HexFud/OptiLogic-16-Pro/bom.csv

Index | LCSC# | MPN | Manufacturer | Package | Customer # | Description | RoHS | Quantity | MOQ | Multiple | Unit Price ($) | Extended Price ($) | Product Link
1 | C17615 | 0805W8F390KT5E | UNI-ROYAL | 0805 |  | 3.9Ω ±1% 125mW 0805 Thick Film Resistor | yes | 100 | 100 | 100 | 0.0056 | 0.56 | https://www.lcsc.com/product-detail/C17615.html
2 | C58758 | KSZ9031RNXCA | MICROCHIP | QFN-48-EP(7x7) |  | PHY Transceiver RGMII QFN-48-EP(7x7) Drivers, Receivers, Transceivers RoHS | yes | 1 | 1 | 1 | 5.8153 | 5.82 | https://www.lcsc.com/product-detail/C58758.html
3 | C22018717 | Y97KT23B0NAFP | C&K | - |  | Tactile Switches RoHS | yes | 1 | 1 | 1 | 0.2131 | 0.21 | https://www.lcsc.com/product-detail/C22018717.html
4 | C3180007 | 0826-1X1T-GH-F | Bel Fuse | Through Hole |  | Jack Modular Connector Through Hole Shielded | yes | 1 | 1 | 1 | 13.8559 | 13.86 | https://www.lcsc.com/product-detail/C3180007.html
5 | C17607 | 0805W8F3091T5E | UNI-ROYAL | 0805 |  | 3.09kΩ ±1% 125mW 0805 Thick Film Resistor | yes | 100 | 100 | 100 | 0.0047 | 0.47 | https://www.lcsc.com/product-detail/C17607.html
6 | C17593 | 0805W8F2702T5E | UNI-ROYAL | 0805 |  | 27kΩ ±1% 125mW 0805 Thick Film Resistor | yes | 100 | 100 | 100 | 0.0029 | 0.29 | https://www.lcsc.com/product-detail/C17593.html
7 | C17448 | 0805W8F1372T5E | UNI-ROYAL | 0805 |  | 13.7kΩ ±1% 125mW 0805 Thick Film Resistor | yes | 100 | 100 | 100 | 0.0022 | 0.22 | https://www.lcsc.com/product-detail/C17448.html
8 | C17408 | 0805W8F1000T5E | UNI-ROYAL | 0805 |  | 100Ω ±1% 125mW 0805 Thick Film Resistor | yes | 100 | 100 | 100 | 0.0043 | 0.43 | https://www.lcsc.com/product-detail/C17408.html
9 | C17841 | 0805W8F820JT5E | UNI-ROYAL | 0805 |  | 82Ω ±1% 125mW 0805 Thick Film Resistor | yes | 100 | 100 | 100 | 0.0032 | 0.32 | https://www.lcsc.com/product-detail/C17841.html
10 | C113767 | W25Q128JVSIQ | Winbond | SOIC-8-208mil |  | 128Mbit 2.7V~3.6V 133MHz SPI SOIC-8-208mil Memory RoHS | yes | 1 | 1 | 1 | 2.7906 | 2.79 | https://www.lcsc.com/product-detail/C113767.html
11 | C17412 | 0805W8F1073T5E | UNI-ROYAL | 0805 |  | 107kΩ ±1% 125mW 0805 Thick Film Resistor | yes | 100 | 100 | 100 | 0.0021 | 0.21 | https://www.lcsc.com/product-detail/C17412.html
12 | C17638 | 0805W8F3483T5E | UNI-ROYAL | 0805 |  | 348kΩ ±1% 125mW 0805 Thick Film Resistor | yes | 100 | 100 | 100 | 0.0022 | 0.22 | https://www.lcsc.com/product-detail/C17638.html
13 | C25946 | 0402WGJ0822TCE | UNI-ROYAL | 0402 |  | 8.2kΩ ±5% 62.5mW 0402 Thick Film Resistor | yes | 100 | 100 | 100 | 0.0009 | 0.09 | https://www.lcsc.com/product-detail/C25946.html
14 | C17530 | 0805W8F2701T5E | UNI-ROYAL | 0805 |  | 2.7kΩ ±1% 125mW 0805 Thick Film Resistor | yes | 100 | 100 | 100 | 0.0055 | 0.55 | https://www.lcsc.com/product-detail/C17530.html
15 | C25993 | 0603WAJ0242T5E | UNI-ROYAL | 0603 |  | 2.4kΩ ±5% 100mW 0603 Thick Film Resistor | yes | 100 | 100 | 100 | 0.0020 | 0.20 | https://www.lcsc.com/product-detail/C25993.html
16 | C17414 | 0805W8F1002T5E | UNI-ROYAL | 0805 |  | 10kΩ ±1% 125mW 0805 Thick Film Resistor | yes | 200 | 100 | 100 | 0.0034 | 0.68 | https://www.lcsc.com/product-detail/C17414.html
17 | C17516 | 0805W8F2151T5E | UNI-ROYAL | 0805 |  | 2.15kΩ ±1% 125mW 0805 Thick Film Resistor | yes | 100 | 100 | 100 | 0.0047 | 0.47 | https://www.lcsc.com/product-detail/C17516.html
18 | C17713 | 0805W8F4702T5E | UNI-ROYAL | 0805 |  | 47kΩ ±1% 125mW 0805 Thick Film Resistor | yes | 100 | 100 | 100 | 0.0068 | 0.68 | https://www.lcsc.com/product-detail/C17713.html
19 | C34771 | TPS51200DRCR | TI | VSON-10-EP(3x3) |  | VSON-10-EP(3x3) Special Purpose Regulators RoHS | yes | 1 | 1 | 1 | 0.4807 | 0.48 | https://www.lcsc.com/product-detail/C34771.html
20 | C305914 | 1888247-1 | TE Connectivity | SMD,P=0.8mm,Surface Mount,Right Angle |  | 1 20P -55℃~+105℃ SMD,P=0.8mm,Surface Mount,Right Angle Pluggable Connector Assemblies RoHS | yes | 3 | 1 | 1 | 0.9163 | 2.75 | https://www.lcsc.com/product-detail/C305914.html
21 | C5137262 | SX3M25.000E20F30THN | SCTF | SMD3225-4P |  | Oscillator 25MHz ±20ppm CMOS 1.2V SMD3225-4P | yes | 5 | 1 | 1 | 0.5914 | 2.96 | https://www.lcsc.com/product-detail/C5137262.html
22 | C9006 | X322525MOB4SI | YXC Crystal Oscillators | SMD3225-4P |  | Crystal 25MHz ±10ppm 12pF SMD3225-4P | yes | 15 | 5 | 5 | 0.0959 | 1.44 | https://www.lcsc.com/product-detail/C9006.html
23 | C17226355 | SIT9365AI-4E1-25N160.000000 | SiTime | SMD7050-6P |  | SMD7050-6P Oscillators RoHS | yes | 1 | 1 | 1 | 15.2097 | 15.21 | https://www.lcsc.com/product-detail/C17226355.html
24 | C5265887 | HY50MSMD3225OB1R30 | Huiyuan crystal | SMD3225-4P |  | Crystal 50MHz ±10ppm 20pF 40Ω SMD3225-4P | yes | 5 | 5 | 5 | 0.0954 | 0.48 | https://www.lcsc.com/product-detail/C5265887.html
25 | C1550513 | FT601Q-B-T | FTDI | QFN-76-EP(9x9) |  | USB to FIFO 8 5Gbps QFN-76-EP(9x9) Controllers RoHS | yes | 1 | 1 | 1 | 13.3480 | 13.35 | https://www.lcsc.com/product-detail/C1550513.html
26 | C2984150 | XC7K70T-2FBG676C | AMD/XILINX | FBG-676 |  | 65600 FBG-676 FPGAs (Field Programmable Gate Array) RoHS | yes | 1 | 1 | 1 | 34.7593 | 34.76 | https://www.lcsc.com/product-detail/C2984150.html
27 | C54792 | TPS63700DRCR | TI | VSON-10-EP(3x3) |  | 1.38MHz Buck-Boost Adjustable -15V~-2V 360mA VSON-10-EP(3x3) Voltage Regulators - DC DC Switching Regulators RoHS | yes | 1 | 1 | 1 | 1.7582 | 1.76 | https://www.lcsc.com/product-detail/C54792.html
28 | C134558 | RGA102M1VBK-1320 | Lelon | Through Hole,D12.5xL20mm |  | 1000uF 35V Aluminum Electrolytic Capacitors Through Hole,D12.5xL20mm 2000hrs@105℃ | yes | 100 | 5 | 5 | 0.2003 | 20.03 | https://www.lcsc.com/product-detail/C134558.html
29 | C2871819 | TPS75115QPWPR | TI | HTSSOP-20-EP |  | 1.5V Positive Fixed HTSSOP-20-EP Voltage Regulators - Linear, Low Drop Out (LDO) Regulators RoHS | yes | 1 | 1 | 1 | 4.0493 | 4.05 | https://www.lcsc.com/product-detail/C2871819.html
30 | C131963 | LP5951MF-2.5/NOPB | TI | SOT-23-5 |  | 2.5V Positive Fixed SOT-23-5 Voltage Regulators - Linear, Low Drop Out (LDO) Regulators RoHS | yes | 1 | 1 | 1 | 0.4039 | 0.40 | https://www.lcsc.com/product-detail/C131963.html
31 | C91314 | MR854RLG | onsemi | DO-201AD |  | 150ns 400V 1.04V@3A 3A DO-201AD Single Diodes | yes | 10 | 10 | 10 | 0.0674 | 0.67 | https://www.lcsc.com/product-detail/C91314.html
32 | C2868758 | DAC8568ICPW | TI | TSSOP-16 |  | 5us 2.7V~5.5V 12LSB TSSOP-16 Digital to Analog Converters (DAC) RoHS | yes | 2 | 1 | 1 | 32.1387 | 64.28 | https://www.lcsc.com/product-detail/C2868758.html
33 | C29438 | TPS54620RGYR | TI | VQFN-14-EP(3.5x3.5) |  | Buck Switching Regulator IC Adjustable 0.8V~15V 1 Output 6A VQFN-14-EP(3.5x3.5) | yes | 1 | 1 | 1 | 1.3612 | 1.36 | https://www.lcsc.com/product-detail/C29438.html
34 | C46274 | REF5040AIDR | TI | SOIC-8 |  | 4.096V ±0.1% 4.296V~18V 10mA Fixed SOIC-8 Voltage Reference RoHS | yes | 1 | 1 | 1 | 1.6610 | 1.66 | https://www.lcsc.com/product-detail/C46274.html
35 | C1858145 | LQG15WZ1N4S02D | muRata | 0402 |  | 1.4nH 1A 40mΩ Standard AEC-Q200 | yes | 4 | 1 | 1 | 0.0481 | 0.19 | https://www.lcsc.com/product-detail/C1858145.html
36 | C97253 | TPS563200DDCR | TI | TSOT-23-6 |  | Buck Switching Regulator IC Adjustable 0.76V~7V 1 Output 3A TSOT-23-6 | yes | 4 | 1 | 1 | 1.0779 | 4.31 | https://www.lcsc.com/product-detail/C97253.html
37 | C49215609 | TCC0805X5R107M6R3FT | CCTC | 0805 |  | 100uF X5R ±20% 6.3V 0805 Ceramic Capacitors RoHS | yes | 10 | 1 | 1 | 0.3170 | 3.17 | https://www.lcsc.com/product-detail/C49215609.html
38 | C85840 | BLM21PG221SN1D | muRata | 0805 |  | 220Ω@100MHz 1 Line Ferrite Bead 0805 2A 45mΩ | yes | 20 | 20 | 20 | 0.0349 | 0.70 | https://www.lcsc.com/product-detail/C85840.html
39 | C18198349 | 1812L300/16GR | LUTE | 1812 |  | Polymeric PTC Resettable Fuse 16V 3A Surface Mount 1812 | yes | 10 | 10 | 10 | 0.0603 | 0.60 | https://www.lcsc.com/product-detail/C18198349.html
40 | C916421 | BAV99 | JSMSEMI | SOT-23 |  | Diode Array 1 Pair Series Connection 75V 215mA Surface Mount SOT-23 | yes | 50 | 50 | 50 | 0.0090 | 0.45 | https://www.lcsc.com/product-detail/C916421.html
41 | C2297 | KT-0805G | Hubei KENTO Elec | 0805 |  | Emerald Green 525nm LED Indication - Discrete 2.6V~3.1V 0805 | yes | 100 | 50 | 50 | 0.0166 | 1.66 | https://www.lcsc.com/product-detail/C2297.html
42 | C94121 | CC0805KRX7R9BB102 | YAGEO | 0805 |  | 1nF ±10% 50V Ceramic Capacitor X7R 0805 | yes | 100 | 100 | 100 | 0.0069 | 0.69 | https://www.lcsc.com/product-detail/C94121.html
43 | C19110 | CL21B225KAFNNNE | Samsung Electro-Mechanics | 0805 |  | 2.2uF ±10% 25V Ceramic Capacitor X7R 0805 | yes | 20 | 10 | 10 | 0.0246 | 0.49 | https://www.lcsc.com/product-detail/C19110.html
44 | C45783 | CL21A226MAQNNNE | Samsung Electro-Mechanics | 0805 |  | 22uF ±20% 25V Ceramic Capacitor X5R 0805 | yes | 100 | 20 | 20 | 0.1934 | 19.34 | https://www.lcsc.com/product-detail/C45783.html
45 | C107146 | CC0805KRX7R9BB222 | YAGEO | 0805 |  | 2.2nF ±10% 50V Ceramic Capacitor X7R 0805 | yes | 100 | 100 | 100 | 0.0075 | 0.75 | https://www.lcsc.com/product-detail/C107146.html
46 | C5441174 | 201N1Y02001 | CND-tek | Through Hole |  | Through Hole Pluggable Connector Accessories | yes | 3 | 1 | 1 | 0.6346 | 1.90 | https://www.lcsc.com/product-detail/C5441174.html
47 | C7496652 | FCC0805N430J500BT | FOJAN | 0805 |  | 43pF ±5% 50V Ceramic Capacitor COG 0805 | yes | 100 | 100 | 100 | 0.0073 | 0.73 | https://www.lcsc.com/product-detail/C7496652.html
48 | C376967 | TCC0805X7R273K500DT | CCTC | 0805 |  | 27nF ±10% 50V Ceramic Capacitor X7R 0805 | yes | 100 | 100 | 100 | 0.0085 | 0.85 | https://www.lcsc.com/product-detail/C376967.html
49 | C1804 | CL21C220JBANNNC | Samsung Electro-Mechanics | 0805 |  | 22pF ±5% 50V Ceramic Capacitor C0G 0805 | yes | 150 | 50 | 50 | 0.0123 | 1.85 | https://www.lcsc.com/product-detail/C1804.html
50 | C1779 | CL21A475KAQNNNE | Samsung Electro-Mechanics | 0805 |  | 4.7uF ±10% 25V Ceramic Capacitor X5R 0805 | yes | 120 | 20 | 20 | 0.0346 | 4.15 | https://www.lcsc.com/product-detail/C1779.html
51 | C1792 | 0805CG120J500NT | FH | 0805 |  | 12pF ±5% 50V Ceramic Capacitor C0G 0805 | yes | 100 | 100 | 100 | 0.0084 | 0.84 | https://www.lcsc.com/product-detail/C1792.html
52 | C28323 | CL21B105KBFNNNE | Samsung Electro-Mechanics | 0805 |  | 1uF ±10% 50V Ceramic Capacitor X7R 0805 | yes | 10 | 10 | 10 | 0.0330 | 0.33 | https://www.lcsc.com/product-detail/C28323.html
53 | C440199 | GRM3195C1H153JA01D | muRata | 1206 |  | 15nF ±5% 50V Ceramic Capacitor C0G 1206 | yes | 5 | 5 | 5 | 0.1554 | 0.78 | https://www.lcsc.com/product-detail/C440199.html
54 | C15850 | CL21A106KAYNNNE | Samsung Electro-Mechanics | 0805 |  | 10uF ±10% 25V Ceramic Capacitor X5R 0805 | yes | 20 | 20 | 20 | 0.0441 | 0.88 | https://www.lcsc.com/product-detail/C15850.html
55 | C167225 | FXL1040-R80-M | cjiang | SMD,11.5x10mm |  | 23A 800nH ±20% 29A 2.7mΩ Molded inductor SMD,11.5x10mm Fixed Inductors RoHS | yes | 100 | 5 | 5 | 0.3205 | 32.05 | https://www.lcsc.com/product-detail/C167225.html
56 | C134565 | RGA221M1CBK-0611 | Lelon | Through Hole,D6.3xL11mm |  | 220uF 16V Aluminum Electrolytic Capacitors Through Hole,D6.3xL11mm 2000hrs@105℃ | yes | 100 | 10 | 10 | 0.0438 | 4.38 | https://www.lcsc.com/product-detail/C134565.html
57 | C17444 | 0805W8F1202T5E | UNI-ROYAL | 0805 |  | 12kΩ ±1% 125mW 0805 Thick Film Resistor | yes | 100 | 100 | 100 | 0.0028 | 0.28 | https://www.lcsc.com/product-detail/C17444.html
58 | C17471 | 0805W8F1500T5E | UNI-ROYAL | 0805 |  | 150Ω ±1% 125mW 0805 Thick Film Resistor | yes | 100 | 100 | 100 | 0.0029 | 0.29 | https://www.lcsc.com/product-detail/C17471.html
59 | C17407 | 0805W8F1003T5E (SMT) | UNI-ROYAL | 0805 |  | 100kΩ ±1% 0805 Chip Resistor - Surface Mount | yes | 100 | 100 | 100 | 0.0028 | 0.28 | https://www.lcsc.com/product-detail/C17407.html
60 | C17526 | 0805W8F2401T5E | UNI-ROYAL | 0805 |  | 2.4kΩ ±1% 125mW 0805 Thick Film Resistor | yes | 100 | 100 | 100 | 0.0028 | 0.28 | https://www.lcsc.com/product-detail/C17526.html
61 | C17673 | 0805W8F4701T5E | UNI-ROYAL | 0805 |  | 4.7kΩ ±1% 125mW 0805 Thick Film Resistor | yes | 200 | 100 | 100 | 0.0051 | 1.02 | https://www.lcsc.com/product-detail/C17673.html
62 | C17393 | 0805W8F1651T5E | UNI-ROYAL | 0805 |  | 1.65kΩ ±1% 125mW 0805 Thick Film Resistor | yes | 200 | 100 | 100 | 0.0029 | 0.58 | https://www.lcsc.com/product-detail/C17393.html
63 | C15127 | AO3401A | AOS | SOT-23 |  | 30V 4A Surface Mount SOT-23 | yes | 100 | 5 | 5 | 0.0789 | 7.89 | https://www.lcsc.com/product-detail/C15127.html
64 | C49678 | CC0805KRX7R9BB104 | YAGEO | 0805 |  | 100nF ±10% 50V Ceramic Capacitor X7R 0805 | yes | 100 | 20 | 20 | 0.0206 | 2.06 | https://www.lcsc.com/product-detail/C49678.html
65 | C167220 | FXL0630-4R7-M | cjiang | SMD,7x6.6mm |  | 6A 4.7uH ±20% 9A 33mΩ Molded inductor SMD,7x6.6mm Fixed Inductors RoHS | yes | 15 | 5 | 5 | 0.1695 | 2.54 | https://www.lcsc.com/product-detail/C167220.html
66 | C167222 | FXL0630-8R2-M | cjiang | SMD,7x6.6mm |  | 5A 8.2uH ±20% 60mΩ 6A Molded inductor SMD,7x6.6mm Fixed Inductors RoHS | yes | 5 | 5 | 5 | 0.1695 | 0.85 | https://www.lcsc.com/product-detail/C167222.html
67 | C3095430 | JACK-L-PC-10A-RA(R) | GlobTek, Inc. | - |  | Right Angle DC Power Jack -25℃~+85℃ 2.5mm 6.5mm 10A 50V Power Connectors RoHS | yes | 1 | 1 | 1 | 4.9813 | 4.98 | https://www.lcsc.com/product-detail/C3095430.html
68 | C493445 | 733910083 | MOLEX | Through Hole |  | Connector Receptacle SMA Female Pin 50Ω Through Hole Right Angle | yes | 1 | 1 | 1 | 6.6127 | 6.61 | https://www.lcsc.com/product-detail/C493445.html
69 | C2337 | 2.54-1*40P | BOOMELE(Boom Precision Elec) | Through Hole,P=2.54mm |  | Pin Header 40 Position 2.54mm Pitch Single Row Through Hole -25℃~+85℃ | yes | 5 | 5 | 5 | 0.1607 | 0.80 | https://www.lcsc.com/product-detail/C2337.html
70 | C124380 | B-2100S06P-A110 | Ckmtw | Through Hole,P=2.54mm |  | Pin Header 6 Position 2.54mm Pitch Single Row Through Hole -40℃~+105℃ | yes | 10 | 10 | 10 | 0.0569 | 0.57 | https://www.lcsc.com/product-detail/C124380.html
71 | C2765186 | TYPE-C 16PIN 2MD(073) | SHOU HAN | SMD |  | USB-C (USB TYPE-C) Receptacle Connector 16 Position Surface Mount, Right Angle | yes | 20 | 20 | 20 | 0.0719 | 1.44 | https://www.lcsc.com/product-detail/C2765186.html
 |  |  |  |  |  | 1GBit SFP LC/LC Transciever |  | 3 |  |  |  | 47.99 | https://www.amazon.it/gp/product/B01DD0ZI7I/
 |  |  |  |  |  | LC/LC Fiber cable |  | 3 |  |  |  | 30 | https://www.amazon.it/gp/product/B0HL28KK1X/ref=ox_sc_act_title_12?smid=A3I27YI4UGWCDD&psc=1
 |  |  |  |  |  | 8 Layer PCB + stencil |  | 1 |  |  |  | 180
 |  |  |  |  |  | Laser warning sticker |  | 1 |  |  |  | 6 | https://www.amazon.it/gp/product/B09NP5HWWF/ref=ox_sc_act_title_3?smid=AZV51B80MC0DX&psc=1
 |  |  |  |  |  | Shipping + Tax |  | 1 |  |  |  | 80
 |  |  |  |  |  | TOTAL |  |  |  |  |  | 649.26
