HexFud/OptiLogic-16-Pro/Production/Case_Top.step

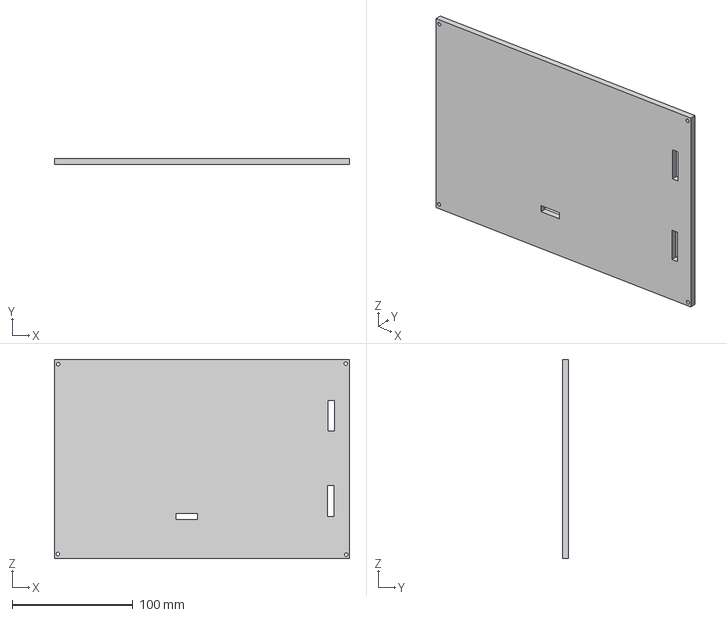
[picture p15: CAD file, 2026-10-24]
Production/Case_Top.step
244.2 x 5.00 x 164.8 mm
