HexFud/OptiLogic-16-Pro/Production/Case_Bottom.step

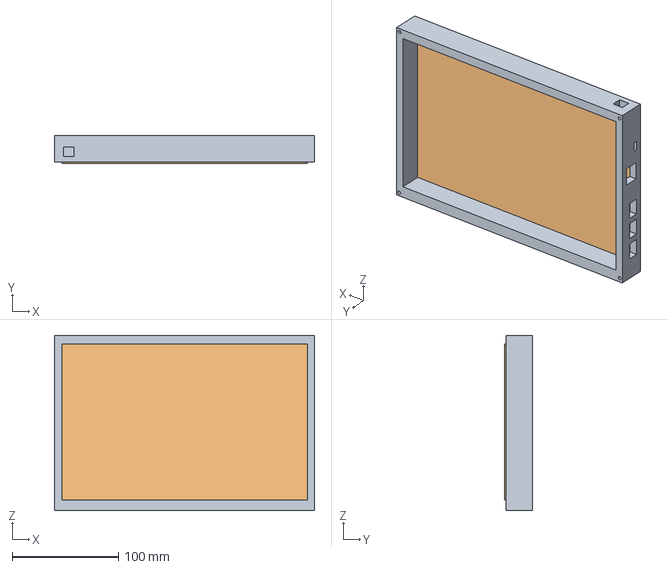
[picture p16: CAD file, 2026-10-24]
Production/Case_Bottom.step
244.2 x 26.5 x 164.8 mm
