HexFud/OptiLogic-16-Pro/(list of files, cad)

Other CAD files:
CAD/OptiLogic_Complete_model.f3z
