HexFud/OptiLogic-16-Pro/PCB/OptiLogic-16-Pro.pdf

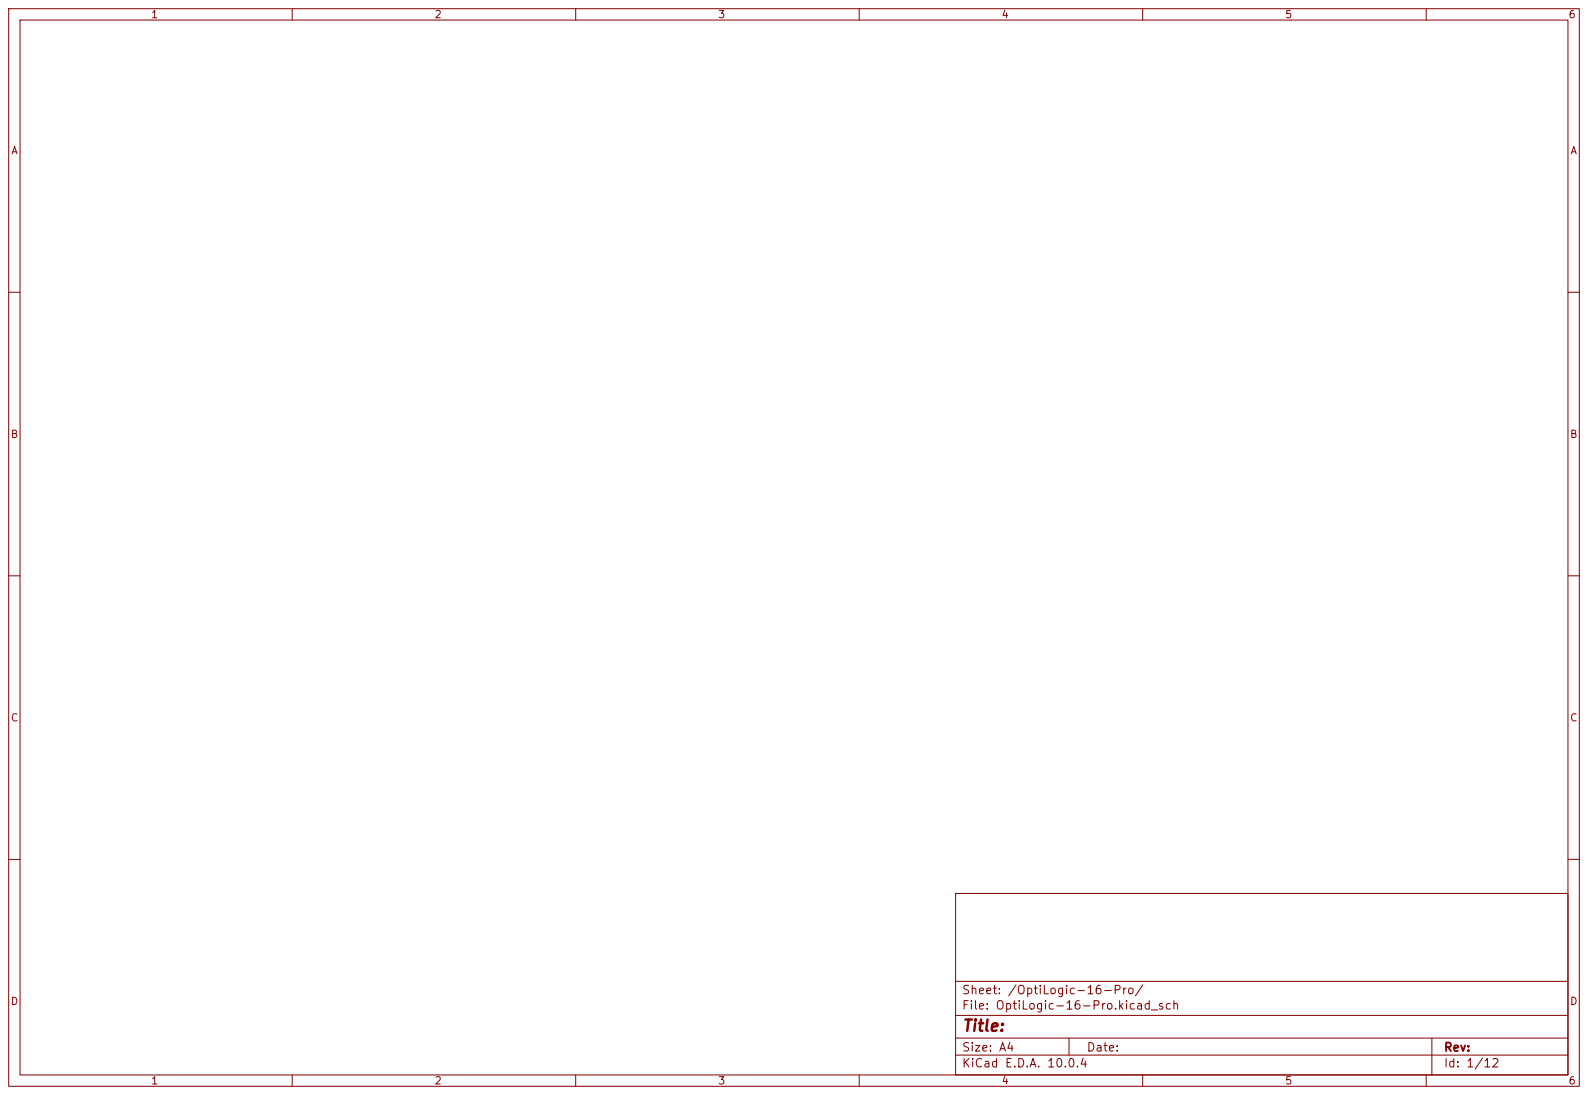
[picture p17: page 1]

Size: A4 | Rev:
KiCad E.D.A. 10.0.4 | Id: 1/12

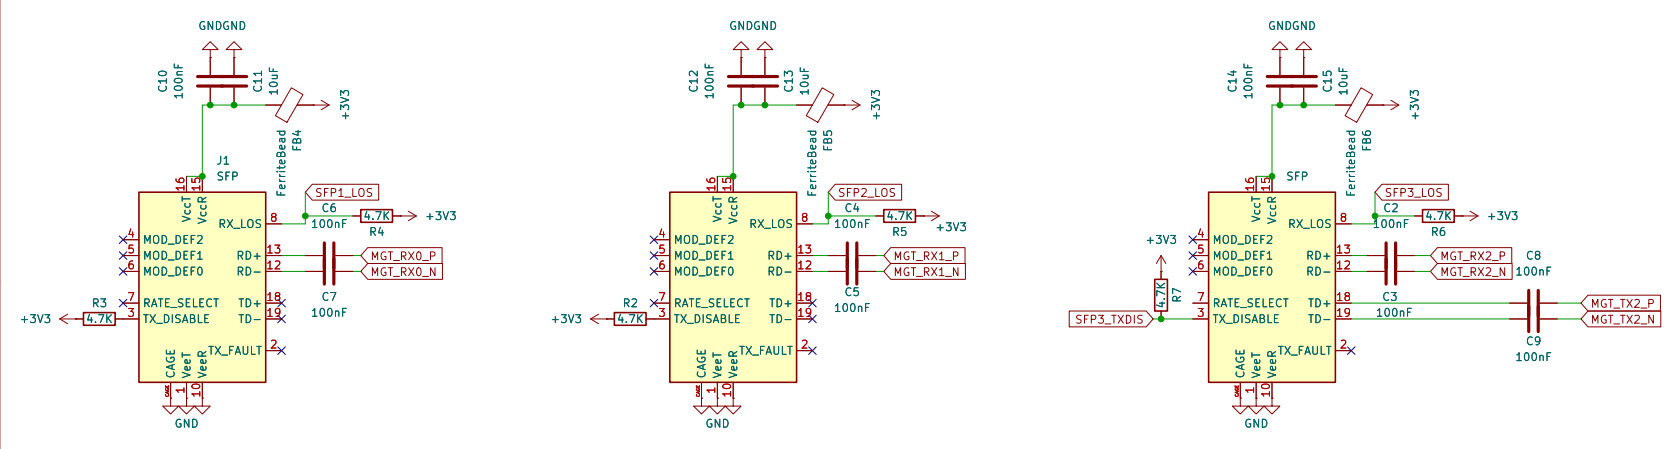
[picture p18: page 2]

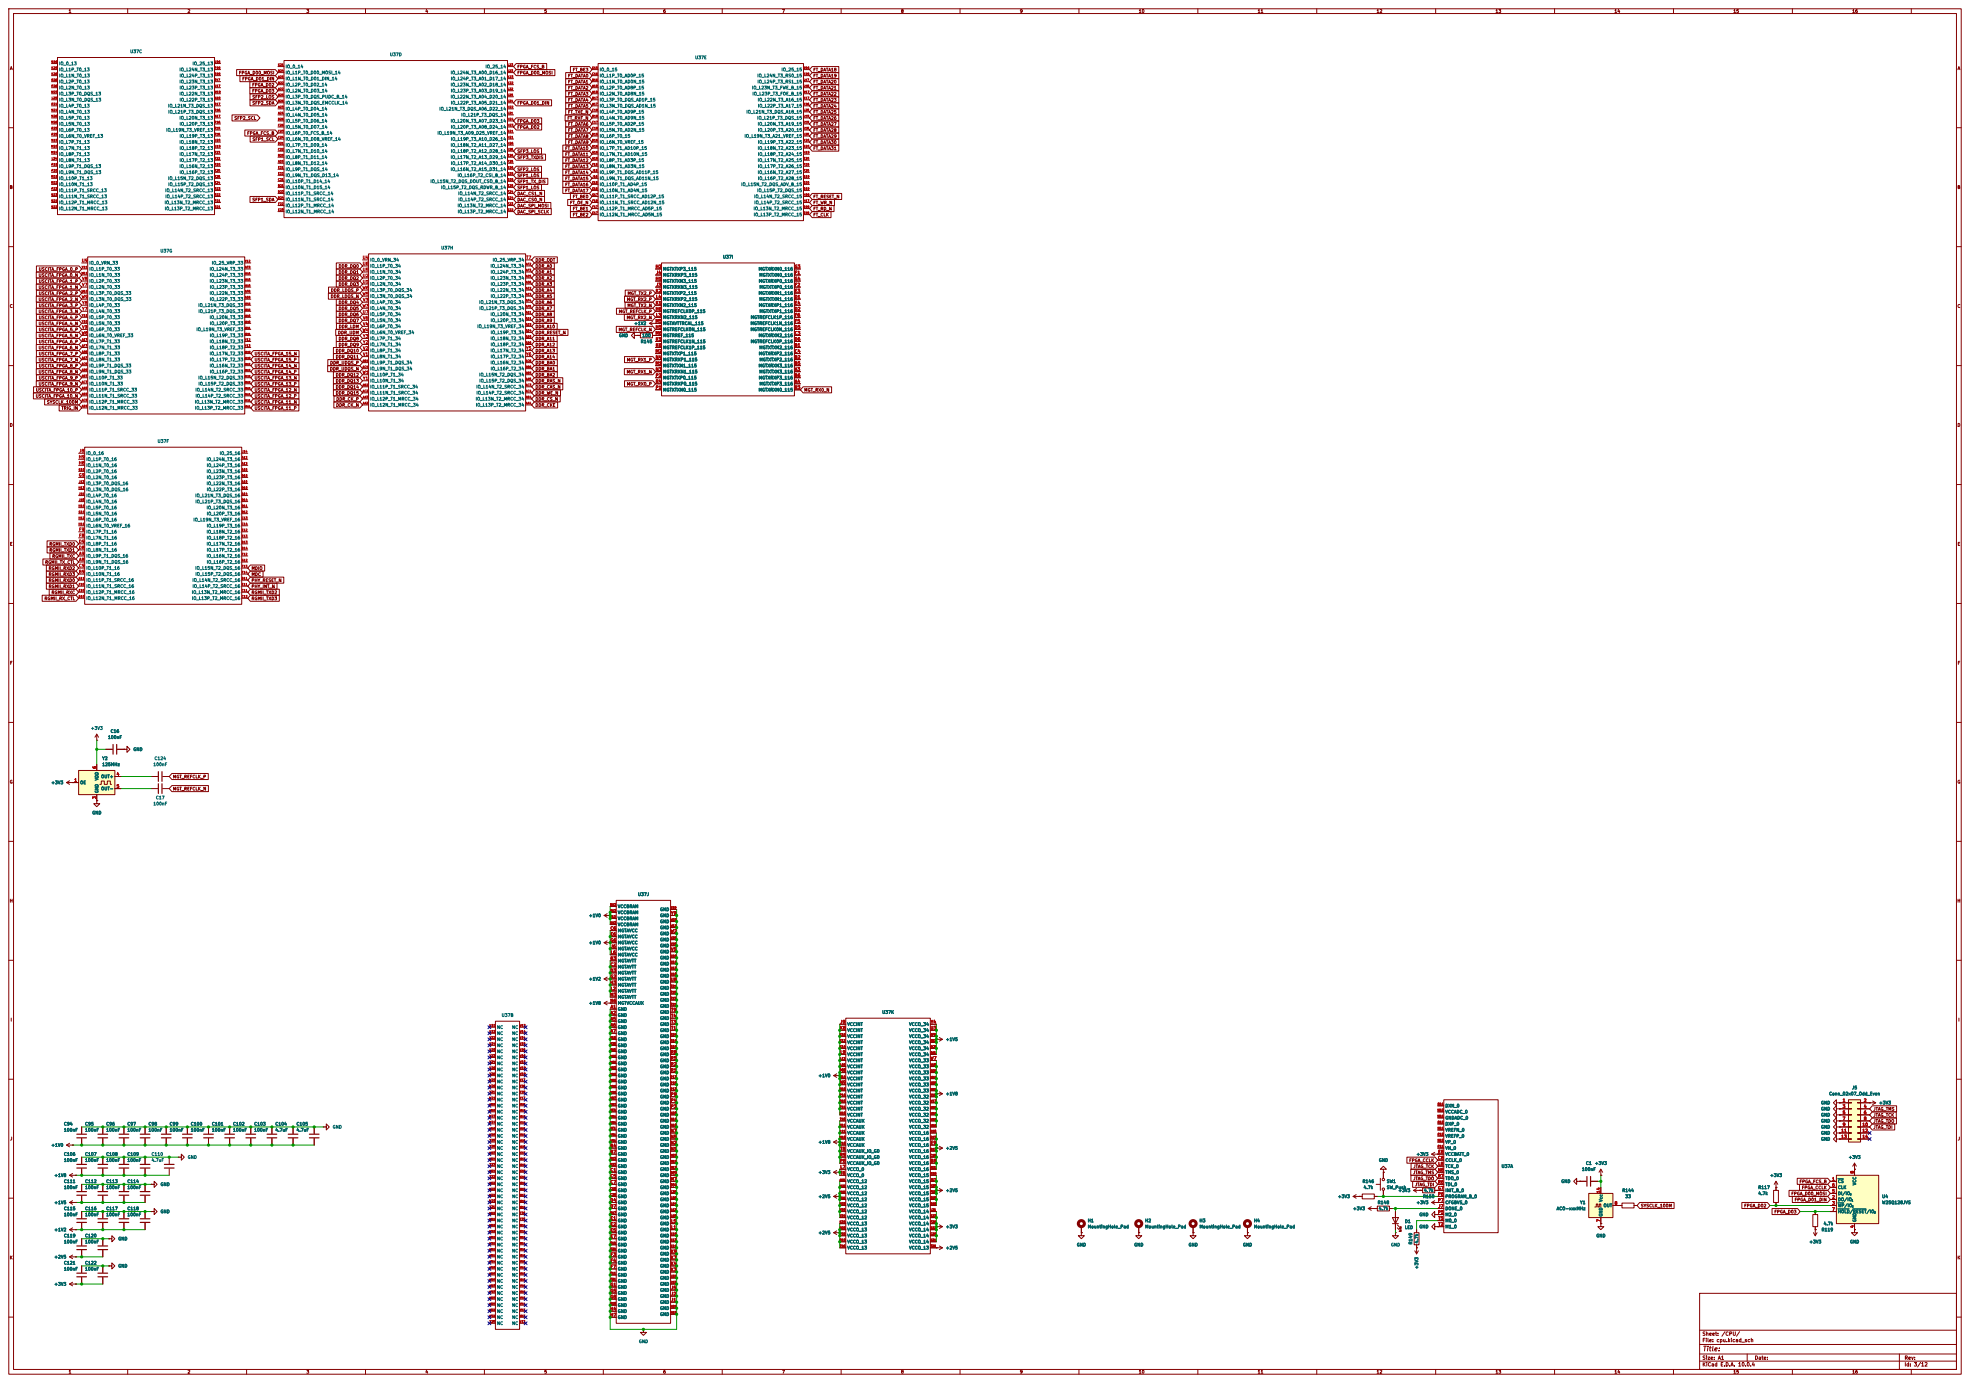
[picture p19: page 3]

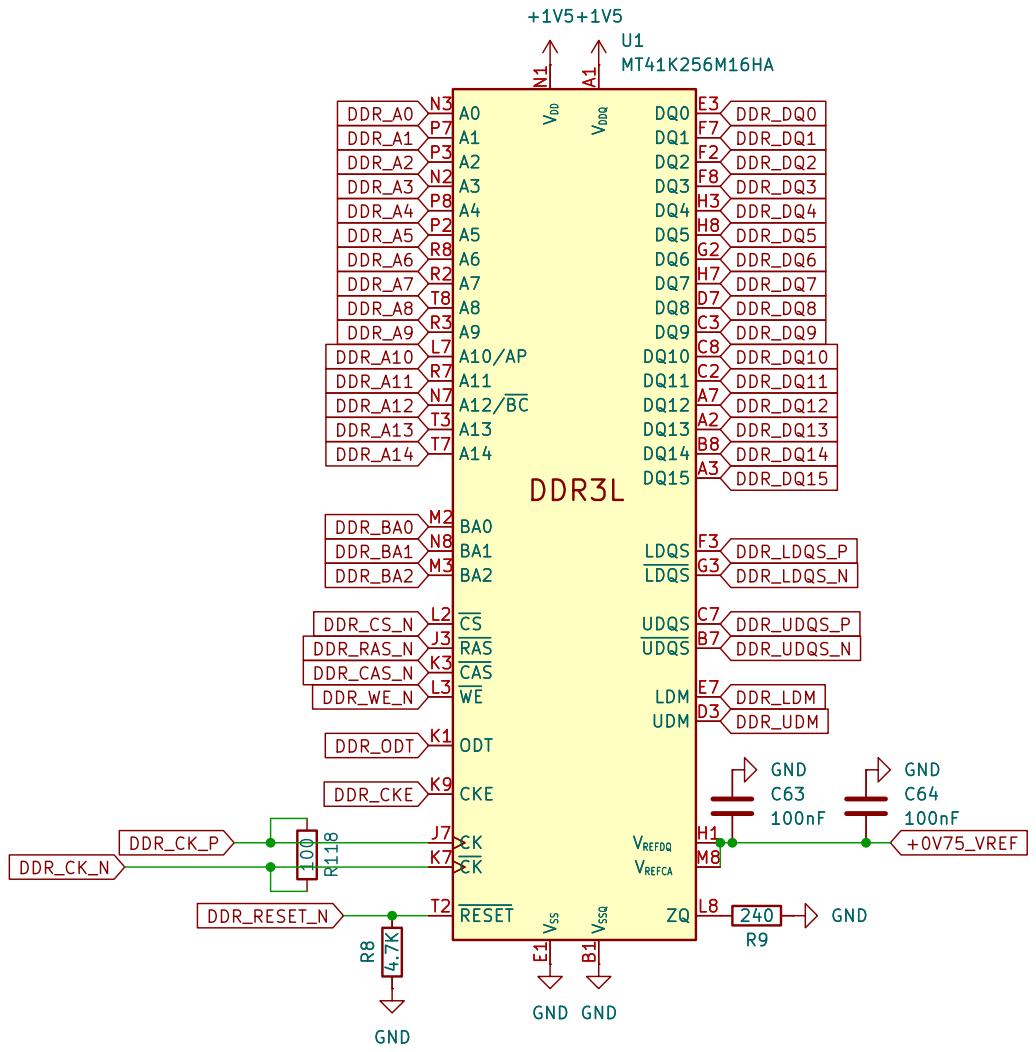
[picture p20: page 4]

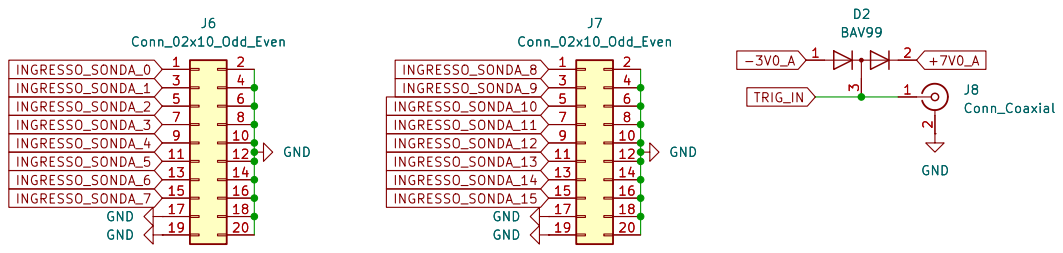
[picture p21: page 5]

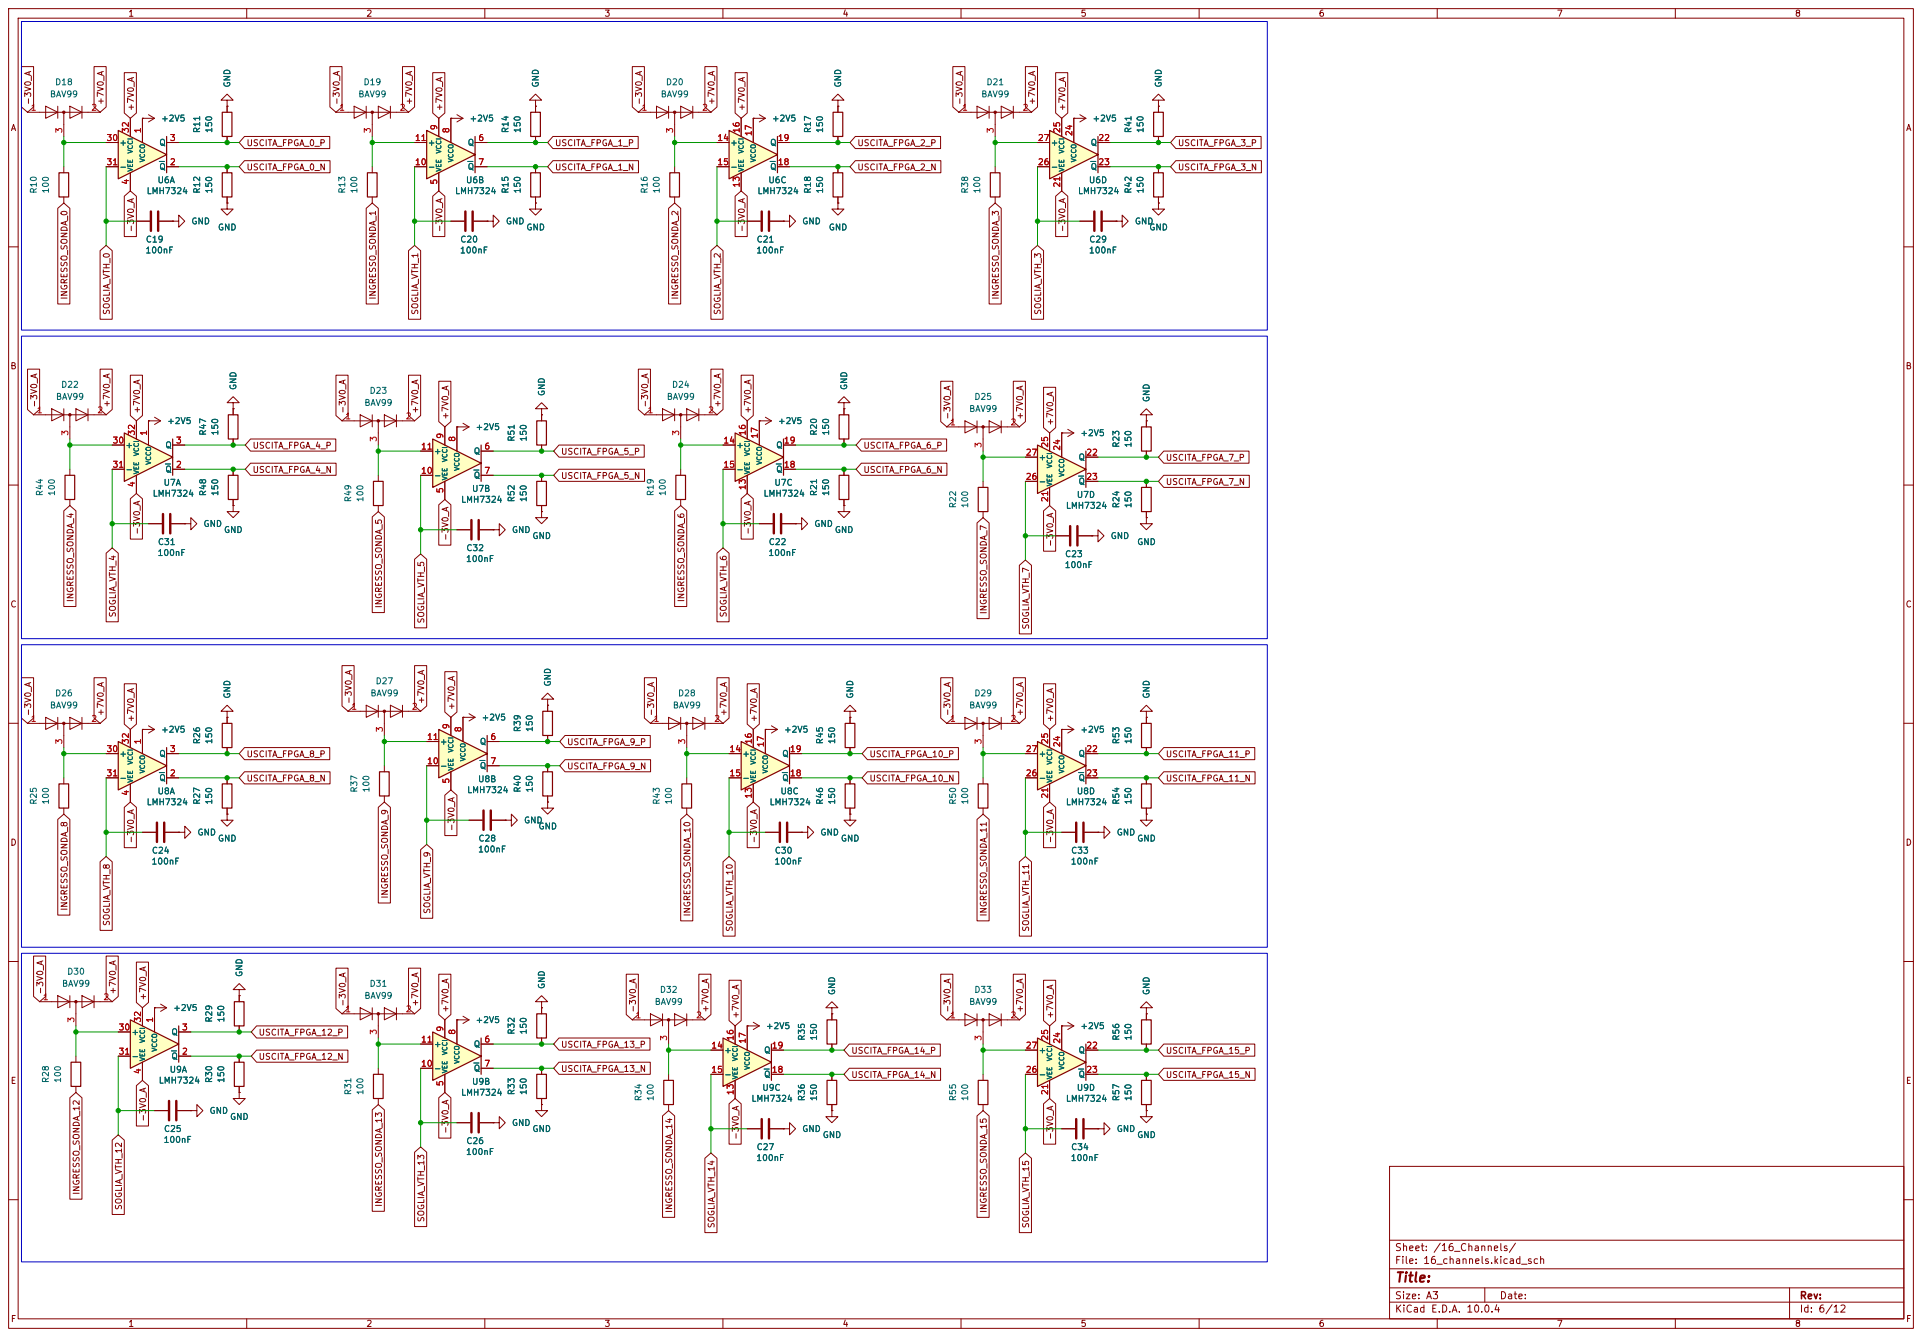
[picture p22: page 6]

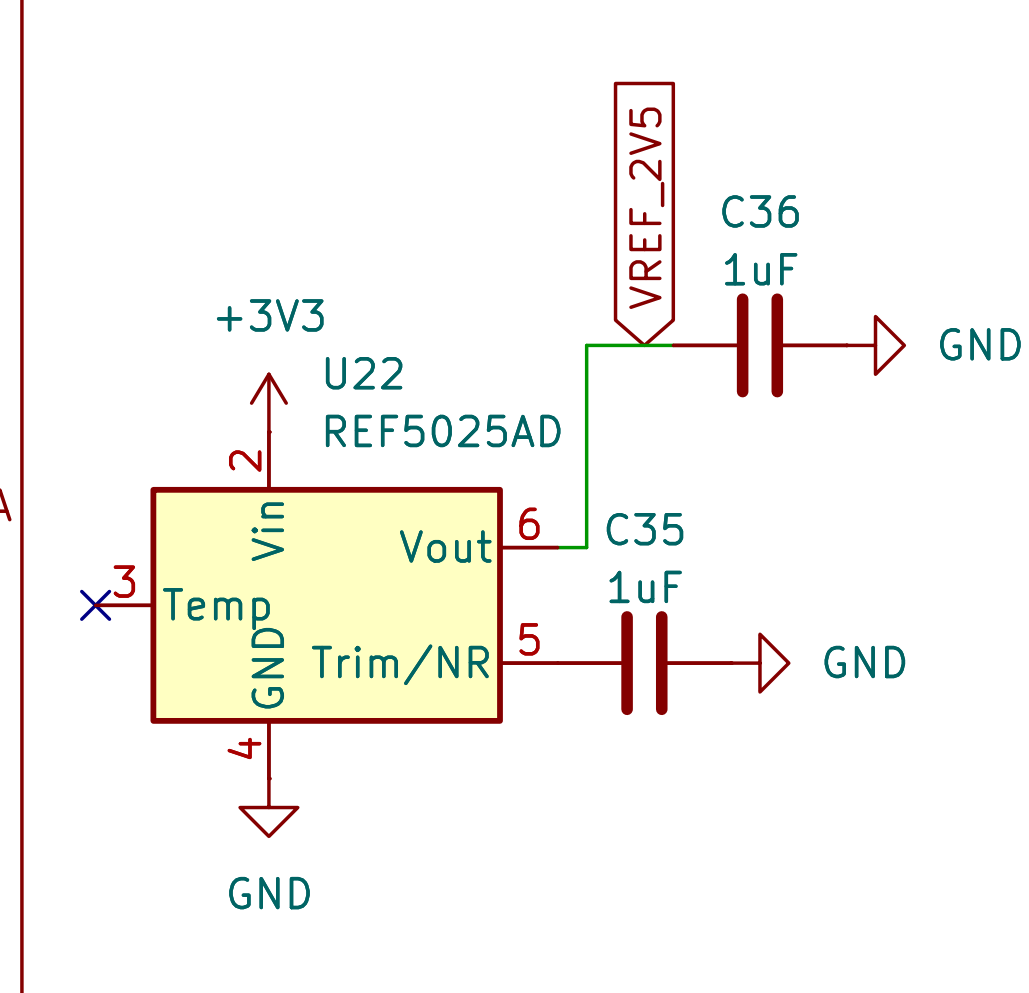
[picture p23: page 7]

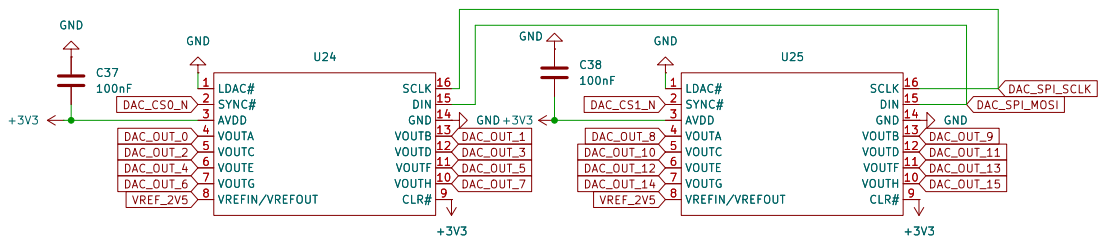
[picture p24: page 8]

VOUTH 10 VOUTF 11 VOUTD 12 VOUTB 13 GND 14 DIN 15 SCLK 16 GND

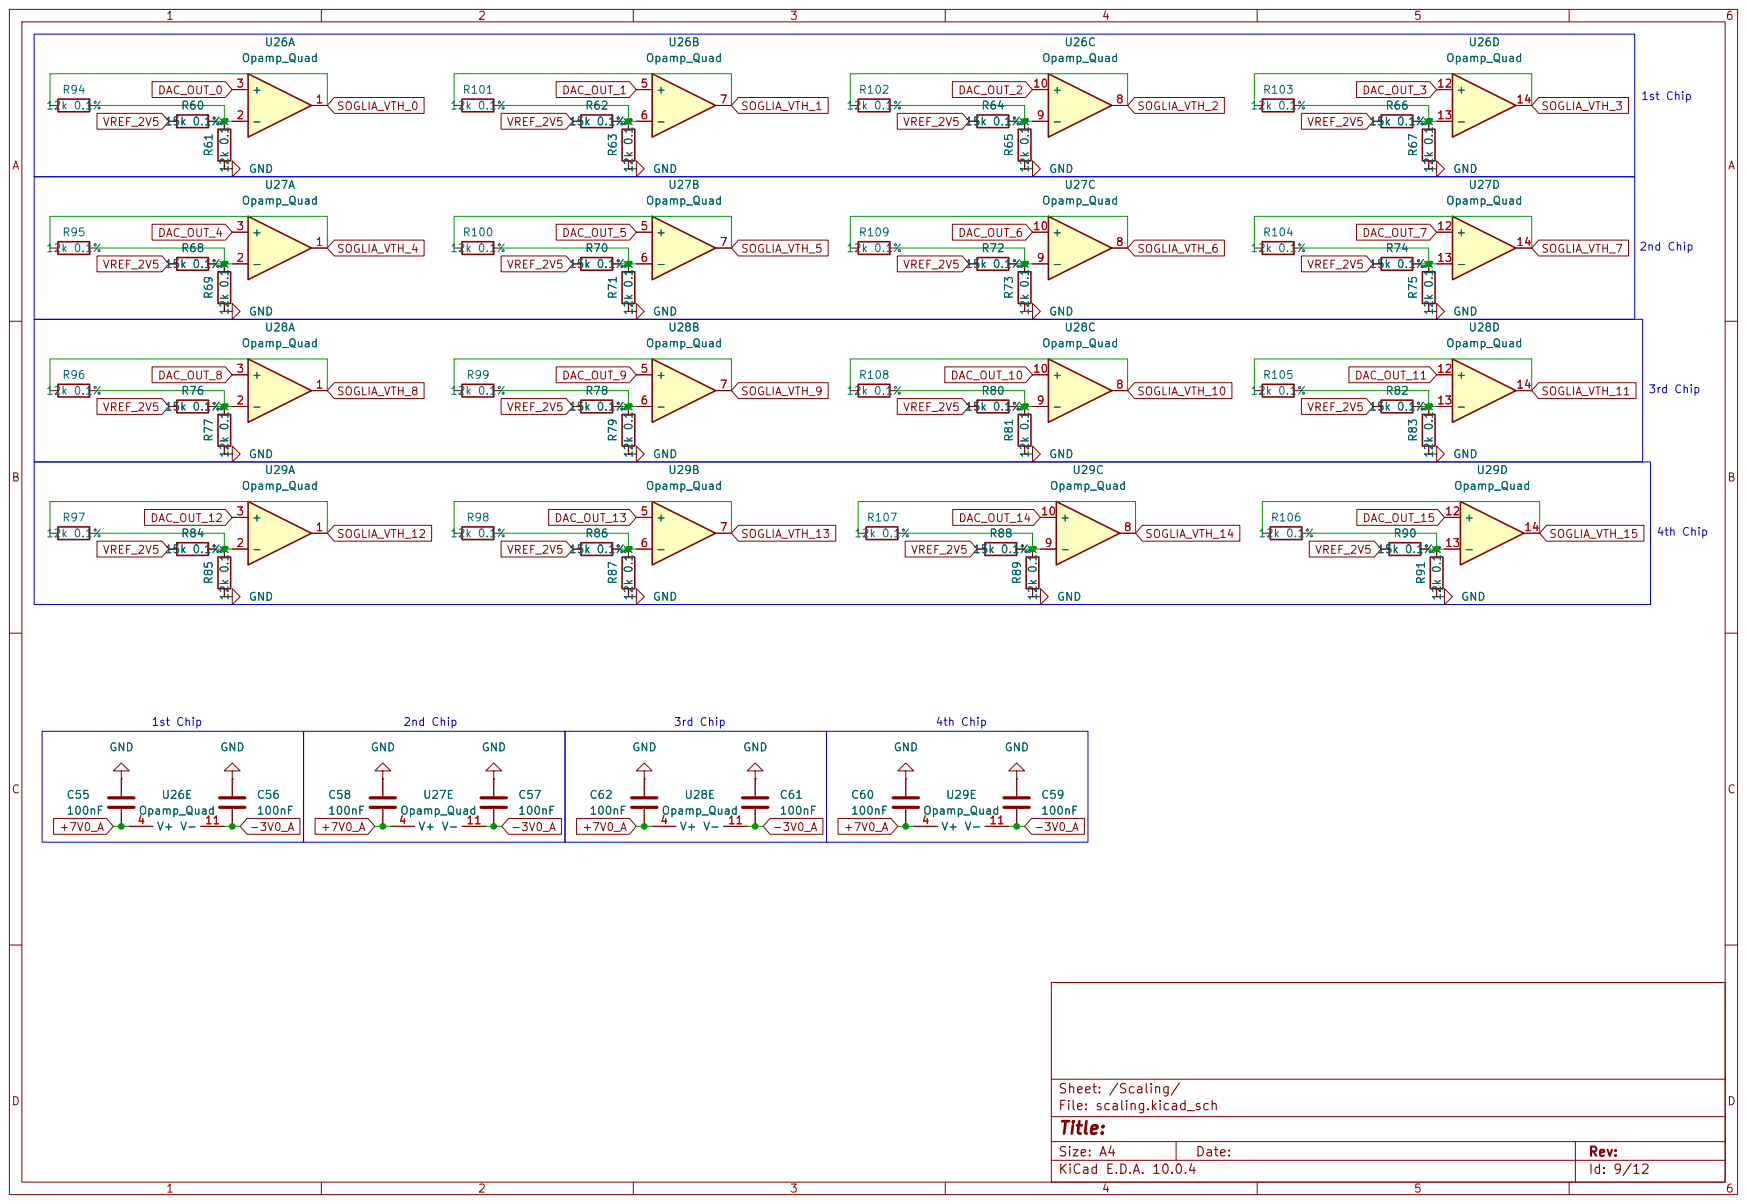
[picture p25: page 9]

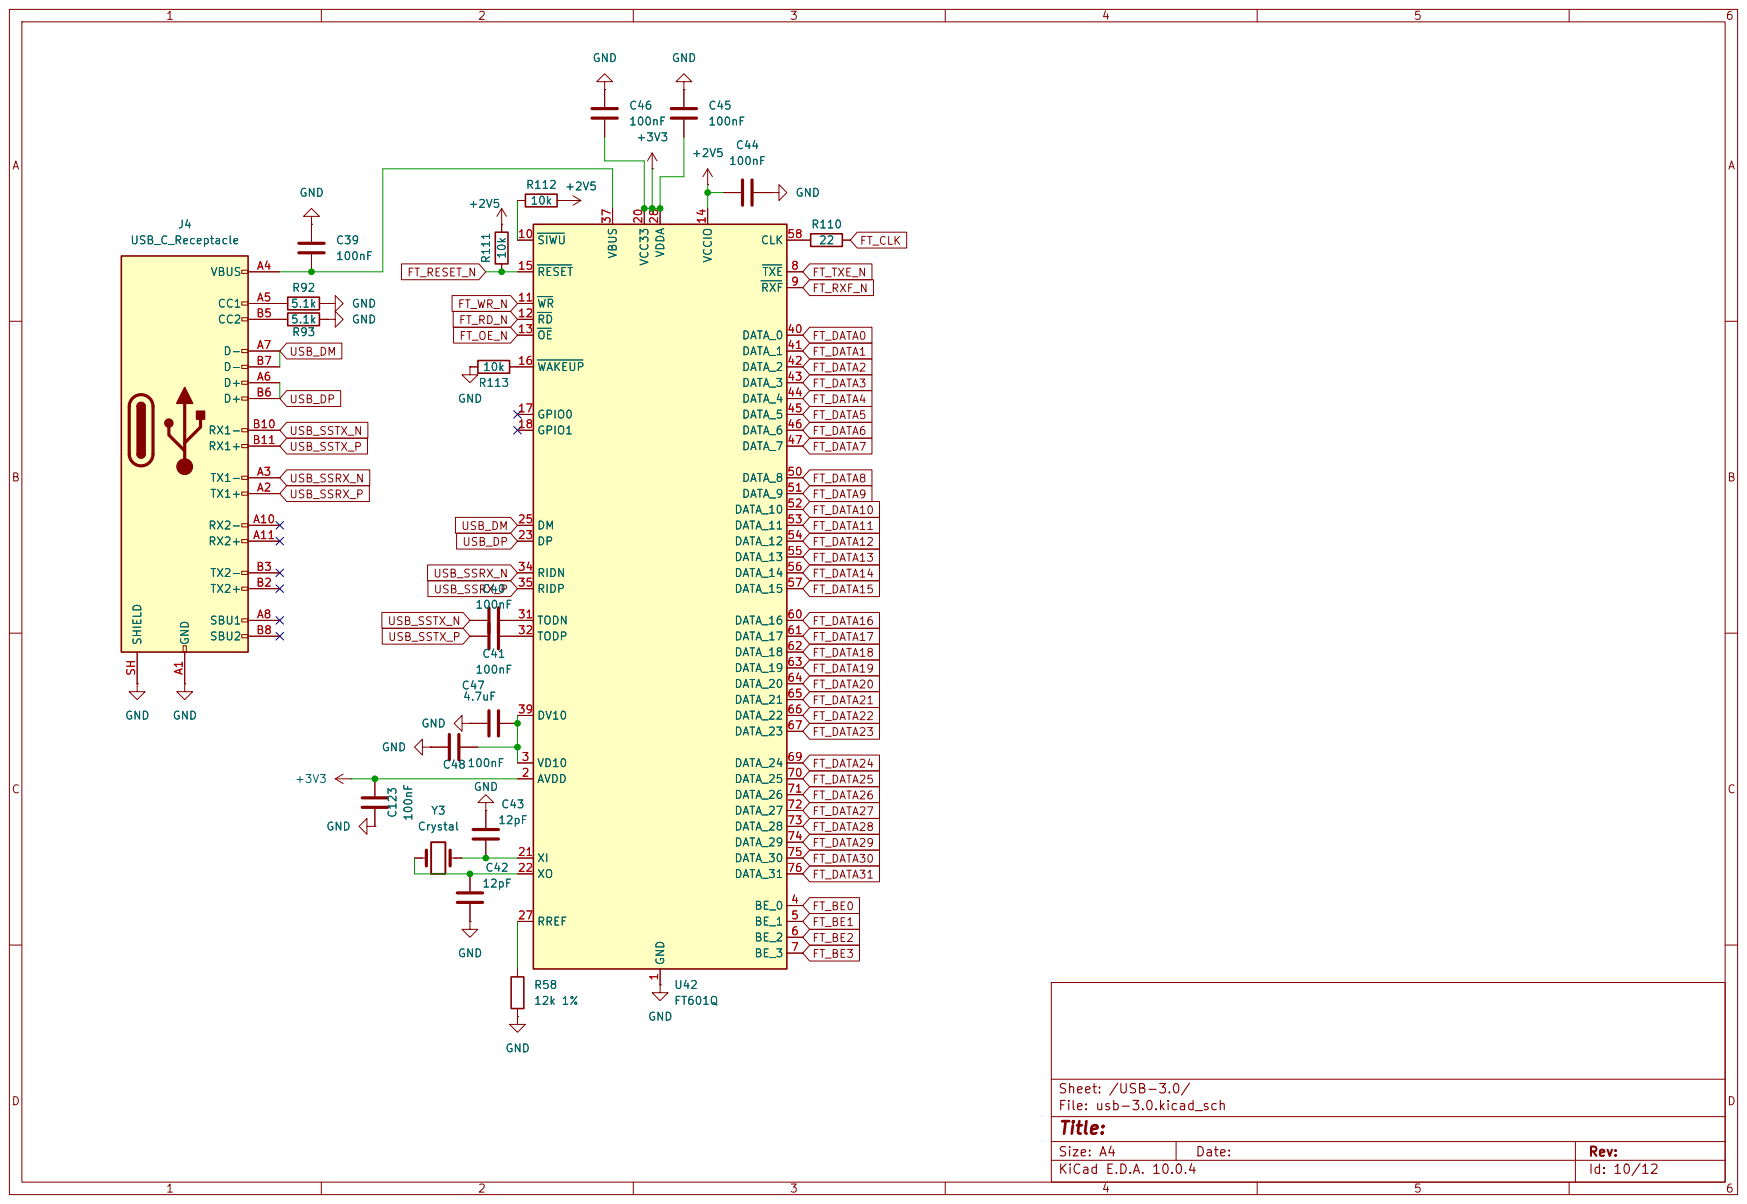
[picture p26: page 10]

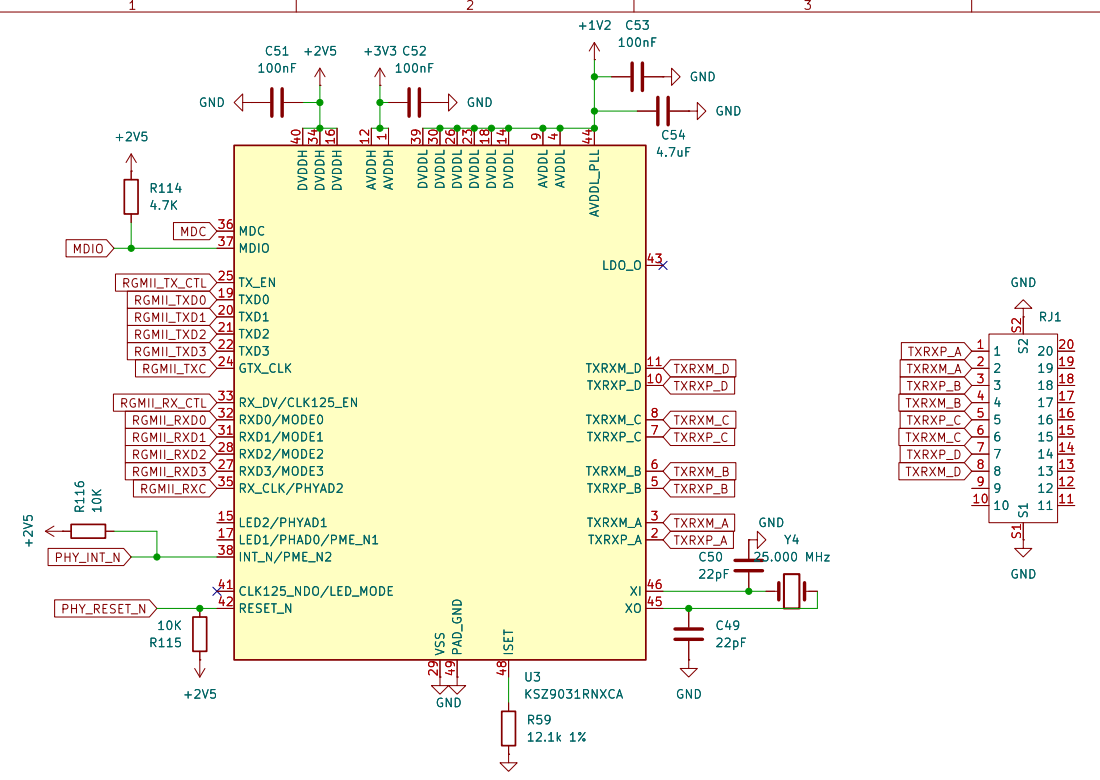
[picture p27: page 11]

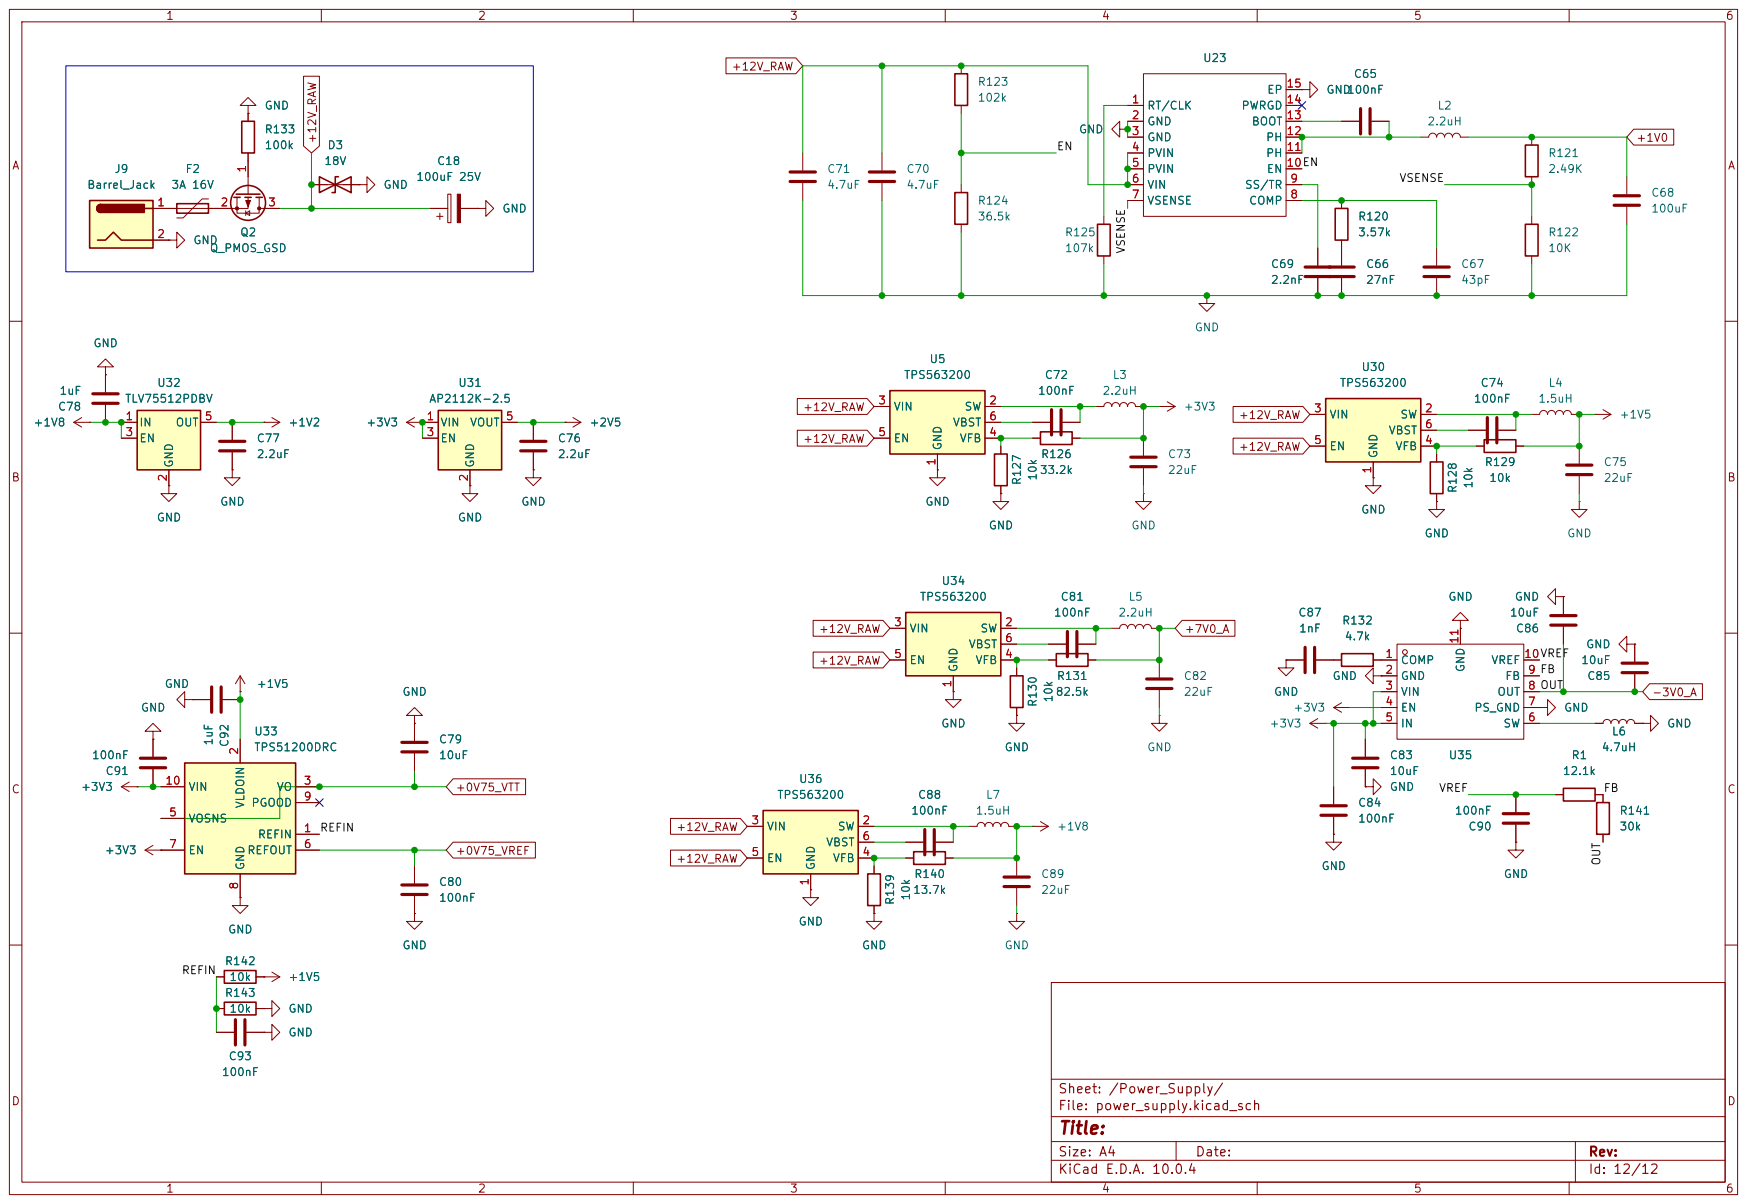
[picture p28: page 12]

EN 10 PH 11 PH 12 BOOT 13 PWRGD 14 EP 15 U23
