HexFud/OptiLogic-16-Pro/PCB/OptiLogic-16-Pro.kicad_pcb

## KiCad design PCB/OptiLogic-16-Pro.kicad_pcb (2026-10-25)

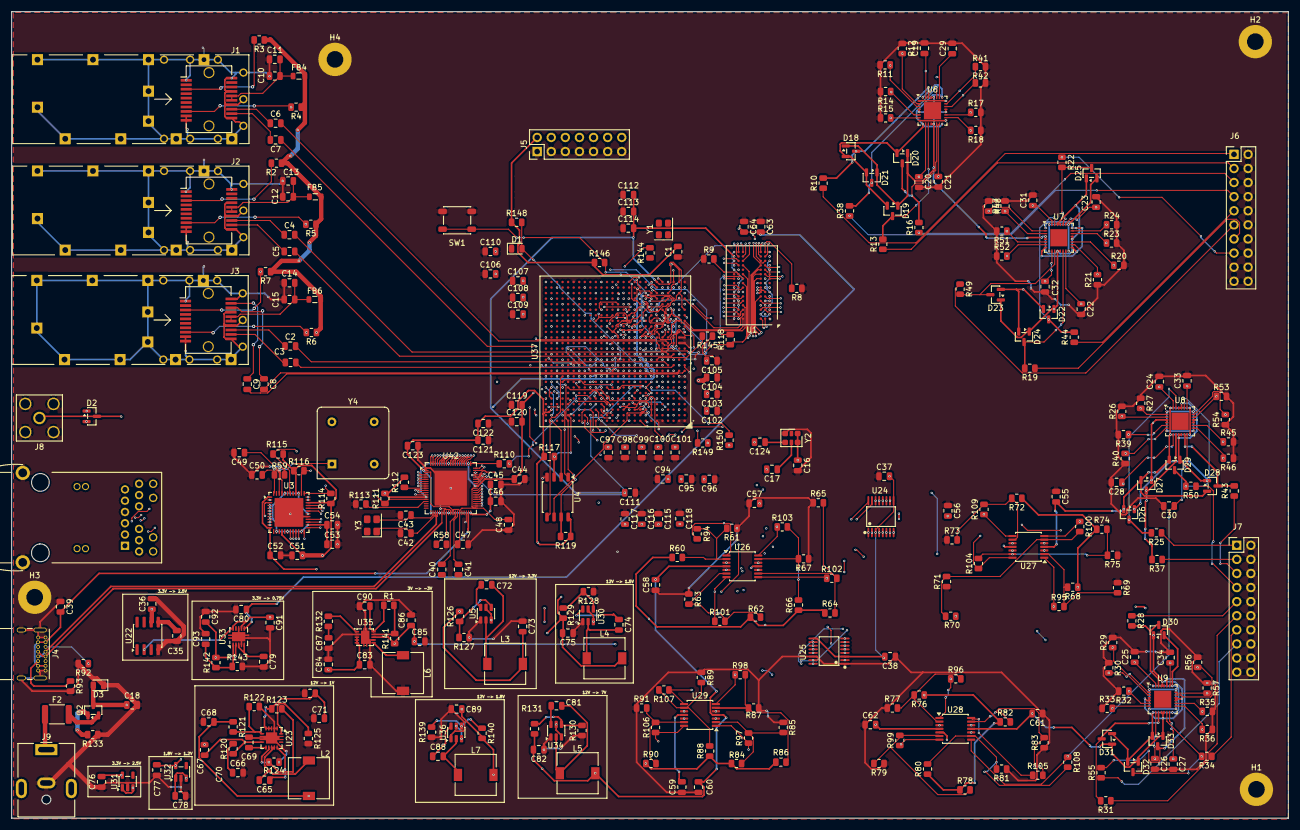
[picture p29: board OptiLogic-16-Pro.kicad_pcb from above]

Board: 8 copper layers, 230.0 x 145.3 mm, 342 parts (0 on the bottom side), 339 nets.

Parts:
C1, C2, C3, C4, C5, C6, C7, C8, C9, C10, C12, C14, C16, C17, C19, C20, C21, C22, C23, C24, C25, C26, C27, C28, C29, C30, C31, C32, C33, C34, C37, C38, C39, C40, C41, C44, C45, C46, C48, C51, C52, C53, C55, C56, C57, C58, C59, C60, C61, C62, C63, C64, C65, C72, C74, C80, C81, C84, C88, C90, C91, C93, C94, C95, C96, C97, C98, C99, C100, C101, C102, C103, C106, C107, C108, C109, C111, C112, C113, C114, C115, C116, C117, C118, C119, C120, C121, C122, C123, C124: 100nF; C_0805_2012Metric
C11, C13, C15, C79, C83, C85, C86: 10uF; C_0805_2012Metric
C18: 100uF 25V; C_0805_2012Metric
C35, C36, C78, C92: 1uF; C_0805_2012Metric
C42, C43: 12pF; C_0805_2012Metric
C47, C54, C70, C71, C104, C105, C110: 4.7uF; C_0805_2012Metric
C49, C50: 22pF; C_0805_2012Metric
C66: 27nF; C_0805_2012Metric
C67: 43pF; C_0805_2012Metric
C68: 100uF; C_0805_2012Metric
C69: 2.2nF; C_0805_2012Metric
C73, C75, C82, C89: 22uF; C_0805_2012Metric
C76, C77: 2.2uF; C_0805_2012Metric
C87: 1nF; C_0805_2012Metric
D1: LED; LED_0805_2012Metric
D2, D18, D19, D20, D21, D22, D23, D24, D25, D26, D27, D28, D29, D30, D31, D32, D33: BAV99; SOT-23
D3: 18V; D_0805_2012Metric
F2: 3A 16V; Fuse_1812_4532Metric
FB4, FB5, FB6: FerriteBead; L_0805_2012Metric
H1, H2, H3, H4: MountingHole_Pad; MountingHole_3mm_Pad
J1, J2, J3: SFP; Connector_SFP_and_Cage
J4: USB_C_Receptacle; USB_C_Receptacle_GCT_USB4085
J5: Conn_02x07_Odd_Even; PinHeader_2x07_P2.54mm_Vertical
J6, J7: Conn_02x10_Odd_Even; PinHeader_2x10_P2.54mm_Vertical
J8: Conn_Coaxial; SMA_Amphenol_132203-12_Horizontal
J9: Barrel_Jack; BarrelJack_CUI_PJ-063AH_Horizontal
L2, L3, L5: 2.2uH; L_7.3x7.3_H3.5
L4, L7: 1.5uH; L_7.3x7.3_H3.5
L6: 4.7uH; L_7.3x7.3_H3.5
Q2: Q_PMOS_GSD; SOT-23
R1: 12.1k; R_0805_2012Metric
R2, R3, R4, R5, R6, R7, R8, R114: 4.7K; R_0805_2012Metric
R9: 240; R_0805_2012Metric
R10, R13, R16, R19, R22, R25, R28, R31, R34, R37, R38, R43, R44, R49, R50, R55, R118, R145: 100; R_0805_2012Metric
R11, R12, R14, R15, R17, R18, R20, R21, R23, R24, R26, R27, R29, R30, R32, R33, R35, R36, R39, R40, R41, R42, R45, R46, R47, R48, R51, R52, R53, R54, R56, R57: 150; R_0805_2012Metric
R58: 12k 1%; R_0805_2012Metric
R59: 12.1k 1%; R_0805_2012Metric
R60, R62, R64, R66, R68, R70, R72, R74, R76, R78, R80, R82, R84, R86, R88, R90: 15k 0.1%; R_0805_2012Metric
R61, R63, R65, R67, R69, R71, R73, R75, R77, R79, R81, R83, R85, R87, R89, R91, R94, R95, R96, R97, R98, R99, R100, R101, R102, R103, R104, R105, R106, R107, R108, R109: 12k 0.1%; R_0805_2012Metric
R92, R93: 5.1k; R_0805_2012Metric
R110: 22; R_0805_2012Metric
R111, R112, R113, R127, R128, R129, R130, R139, R142, R143: 10k; R_0805_2012Metric
R115, R116, R122: 10K; R_0805_2012Metric
R117, R119, R132, R146, R148, R149, R150: 4.7k; R_0805_2012Metric
R120: 3.57k; R_0805_2012Metric
R121: 2.49K; R_0805_2012Metric
R123: 102k; R_0805_2012Metric
R124: 36.5k; R_0805_2012Metric
R125: 107k; R_0805_2012Metric
R126: 33.2k; R_0805_2012Metric
R131: 82.5k; R_0805_2012Metric
R133: 100k; R_0805_2012Metric
R140: 13.7k; R_0805_2012Metric
R141: 30k; R_0805_2012Metric
R144: 33; R_0805_2012Metric
RJ1: RJ45-TH_0826-1X1T-HT-F
SW1: SW_Push; SW_SPST_PTS647_Sx38
U1: MT41K256M16HA; Micron_FBGA-96_9x14mm_Layout9x16_P0.8mm
U3: KSZ9031RNXCA; QFN-48-1EP_7x7mm_P0.5mm_EP5.15x5.15mm
U4: W25Q128JVS; SOIC-8_5.3x5.3mm_P1.27mm
U5, U30, U34, U36: TPS563200; SOT-23-6
U6, U7, U8, U9: LMH7324; WQFN-32-1EP_5x5mm_P0.5mm_EP3.1x3.1mm
U22: REF5025AD; SOIC-8_3.9x4.9mm_P1.27mm
U23: VQFN-14_L3.5-W3.5-P0.50-BL-EP_TPS54622RHLT
U24, U25: TSSOP-16_L5.0-W4.4-P0.65-LS6.4-BL
U26, U27, U28, U29: Opamp_Quad; TSSOP-14_4.4x5mm_P0.65mm
U31: AP2112K-2.5; SOT-23-5
U32: TLV75512PDBV; SOT-23-5
U33: TPS51200DRC; VSON-10-1EP_3x3mm_P0.5mm_EP1.65x2.4mm
U35: VSON-10_L3.0-W3.0-P0.50-TL-EP-1
U37: FBGA-676_L27.0-W27.0-R26-C26-P1.00-BL
U42: FT601Q; QFN-76-1EP_9x9mm_P0.4mm_EP5.81x6.31mm
Y1: ACO-xxxMHz; Oscillator_SMD_Abracon_ASE-4Pin_3.2x2.5mm
Y2: 125MHz; Oscillator_SMD_SiTime_PQFD-6L_3.2x2.5mm
Y3: Crystal; Crystal_SMD_3225-4Pin_3.2x2.5mm
Y4: 25.000 MHz; Oscillator_DIP-8

Connections:
+0V75_VREF: C63.2, C64.2, C80.1, U1.H1 (V_{REFDQ}), U1.M8 (V_{REFCA}), U33.6 (REFOUT)
+0V75_VTT: C79.1, U33.3 (VO), U33.5 (VOSNS)
+1V0: C68.2, C94.2, C95.2, C96.2, C97.2, C98.2, C99.2, C100.2, C101.2, C102.2, C103.2, C104.2, C105.2, L2.2, R121.1, U37.C6 (MGTAVCC), U37.E6 (MGTAVCC), U37.G6 (MGTAVCC), U37.J6 (MGTAVCC), U37.J9 (VCCINT), U37.K8 (VCCINT), U37.K10 (VCCINT), U37.K12 (VCCINT), U37.K14 (VCCINT), U37.L6 (MGTAVCC), U37.L9 (VCCINT), U37.L13 (VCCINT), U37.L15 (VCCINT), U37.M8 (VCCINT), U37.M14 (VCCINT), U37.N9 (VCCINT), U37.N13 (VCCBRAM), U37.N15 (VCCINT), U37.P14 (VCCINT), U37.R13 (VCCBRAM), U37.R15 (VCCINT), U37.T12 (VCCBRAM), U37.T14 (VCCINT), U37.U13 (VCCBRAM), U37.U15 (VCCINT)
+1V2: C53.1, C54.1, C77.2, C115.2, C116.2, C117.2, C118.2, U3.4 (AVDDL), U3.9 (AVDDL), U3.14 (DVDDL), U3.18 (DVDDL), U3.23 (DVDDL), U3.26 (DVDDL), U3.30 (DVDDL), U3.39 (DVDDL), U3.44 (AVDDL_PLL), U32.5 (OUT), U37.B3 (MGTAVTT), U37.C2 (MGTAVTT), U37.D3 (MGTAVTT), U37.G2 (MGTAVTT), U37.H3 (MGTAVTT), U37.L2 (MGTAVTT), U37.M3 (MGTAVTT), U37.M5 (MGTAVTTRCAL_115)
+1V5: C75.2, C92.2, C111.2, C112.2, C113.2, C114.2, L4.2, R129.2, R142.2, U1.A1 (V_{DDQ}), U1.A8 (V_{DDQ}), U1.B2 (V_{DD}), U1.C1 (V_{DDQ}), U1.C9 (V_{DDQ}), U1.D2 (V_{DDQ}), U1.D9 (V_{DD}), U1.E9 (V_{DDQ}), U1.F1 (V_{DDQ}), U1.G7 (V_{DD}), U1.H2 (V_{DDQ}), U1.H9 (V_{DDQ}), U1.K2 (V_{DD}), U1.K8 (V_{DD}), U1.N1 (V_{DD}), U1.N9 (V_{DD}), U1.R1 (V_{DD}), U1.R9 (V_{DD}), U33.2 (VLDOIN), U37.AA1 (VCCO_34), U37.AC5 (VCCO_34), U37.AD2 (VCCO_34), U37.AF6 (VCCO_34), U37.U3 (VCCO_34), U37.Y4 (VCCO_34)
+1V8: C78.2, C89.2, C106.2, C107.2, C108.2, C109.2, C110.2, L7.2, R140.2, U32.1 (IN), U32.3 (EN), U37.AA11 (VCCO_33), U37.AB8 (VCCO_33), U37.AB18 (VCCO_32), U37.AC15 (VCCO_32), U37.AD12 (VCCO_33), U37.AE9 (VCCO_33), U37.AE19 (VCCO_32), U37.AF16 (VCCO_32), U37.L11 (VCCAUX), U37.M10 (VCCAUX), U37.N6 (MGTVCCAUX), U37.P8 (VCCAUX_IO_G0), U37.P10 (VCCAUX), U37.R9 (VCCAUX_IO_G0), U37.T8 (VCCAUX_IO_G0), U37.T10 (VCCAUX), U37.U11 (VCCAUX), U37.V10 (VCCO_33), U37.W7 (VCCO_33), U37.W17 (VCCO_32), U37.Y14 (VCCO_32)
+2V5: C44.1, C51.2, C76.2, C119.2, C120.2, R111.2, R112.2, R114.1, R115.1, R116.1, U3.16 (DVDDH), U3.34 (DVDDH), U3.40 (DVDDH), U6.1 (VCCO), U6.8 (VCCO), U6.17 (VCCO), U6.24 (VCCO), U7.1 (VCCO), U7.8 (VCCO), U7.17 (VCCO), U7.24 (VCCO), U8.1 (VCCO), U8.8 (VCCO), U8.17 (VCCO), U8.24 (VCCO), U9.1 (VCCO), U9.8 (VCCO), U9.17 (VCCO), U9.24 (VCCO), U31.5 (VOUT), U37.A11 (VCCO_16), U37.AA21 (VCCO_12), U37.AC25 (VCCO_12), U37.AD22 (VCCO_12), U37.AF26 (VCCO_12), U37.B8 (VCCO_16), U37.B18 (VCCO_15), U37.C15 (VCCO_16), U37.D12 (VCCO_16), U37.E9 (VCCO_16), U37.E19 (VCCO_15), U37.F16 (VCCO_15), U37.G13 (VCCO_16), U37.H10 (VCCO_16), U37.H20 (VCCO_15), U37.J17 (VCCO_15), U37.K24 (VCCO_13), U37.M18 (VCCO_15), U37.N25 (VCCO_13), U37.P22 (VCCO_13), U37.R19 (VCCO_13), U37.T16 (VCCO_13), U37.T26 (VCCO_13), U37.U23 (VCCO_12), U37.V20 (VCCO_12), U37.Y24 (VCCO_12), U42.14 (VCCIO), U42.49 (VCCIO), U42.59 (VCCIO), U42.68 (VCCIO)
+3V3: C1.2, C16.1, C37.2, C38.2, C45.1, C46.1, C52.1, C73.2, C83.1, C84.1, C91.1, C121.2, C122.2, C123.2, FB4.2, FB5.2, FB6.2, J5.2, L3.2, R2.1, R3.1, R4.1, R5.1, R6.1, R7.1, R117.1, R119.1, R126.2, R146.1, R148.1, R149.1, R150.1, U3.1 (AVDDH), U3.12 (AVDDH), U4.8 (VCC), U22.2 (Vin), U24.3 (AVDD), U24.9 (CLR#), U25.3 (AVDD), U25.9 (CLR#), U31.1 (VIN), U31.3 (EN), U33.7 (EN), U33.10 (VIN), U35.3 (VIN), U35.4 (EN), U35.5 (IN), U37.A21 (VCCO_14), U37.C25 (VCCO_14), U37.D22 (VCCO_14), U37.E8 (VCCBATT_0), U37.F26 (VCCO_14), U37.G23 (VCCO_14), U37.L7 (VCCO_0), U37.L21 (VCCO_14), U37.P7 (CFGBVS_0), U37.T6 (VCCO_0), U42.2 (AVDD), U42.20 (VCC33), U42.24 (VCC33), U42.28 (VDDA), U42.38 (VCC33), Y2.1 (OE), Y2.6 (VDD)
+7V0_A: C55.2, C58.2, C60.2, C62.2, C82.2, D2.2 (A), D18.2 (A), D19.2 (A), D20.2 (A), D21.2 (A), D22.2 (A), D23.2 (A), D24.2 (A), D25.2 (A), D26.2 (A), D27.2 (A), D28.2 (A), D29.2 (A), D30.2 (A), D31.2 (A), D32.2 (A), D33.2 (A), L5.2, R131.2, U6.9 (VCCI), U6.16 (VCCI), U6.25 (VCCI), U6.32 (VCCI), U7.9 (VCCI), U7.16 (VCCI), U7.25 (VCCI), U7.32 (VCCI), U8.9 (VCCI), U8.16 (VCCI), U8.25 (VCCI), U8.32 (VCCI), U9.9 (VCCI), U9.16 (VCCI), U9.25 (VCCI), U9.32 (VCCI), U26.4 (V+), U27.4 (V+), U28.4 (V+), U29.4 (V+)
+12V_RAW: C18.1, C70.2, C71.2, D3.2 (A2), Q2.3 (D), R123.1, U5.3 (VIN), U5.5 (EN), U23.4 (PVIN), U23.5 (PVIN), U23.6 (VIN), U30.3 (VIN), U30.5 (EN), U34.3 (VIN), U34.5 (EN), U36.3 (VIN), U36.5 (EN)
-3V0_A: C56.2, C57.2, C59.2, C61.2, C85.1, C86.1, D2.1 (K), D18.1 (K), D19.1 (K), D20.1 (K), D21.1 (K), D22.1 (K), D23.1 (K), D24.1 (K), D25.1 (K), D26.1 (K), D27.1 (K), D28.1 (K), D29.1 (K), D30.1 (K), D31.1 (K), D32.1 (K), D33.1 (K), R141.1, U6.4 (VEE), U6.5 (VEE), U6.12 (VEE), U6.13 (VEE), U6.20 (VEE), U6.21 (VEE), U6.28 (VEE), U6.29 (VEE), U7.4 (VEE), U7.5 (VEE), U7.12 (VEE), U7.13 (VEE), U7.20 (VEE), U7.21 (VEE), U7.28 (VEE), U7.29 (VEE), U8.4 (VEE), U8.5 (VEE), U8.12 (VEE), U8.13 (VEE), U8.20 (VEE), U8.21 (VEE), U8.28 (VEE), U8.29 (VEE), U9.4 (VEE), U9.5 (VEE), U9.12 (VEE), U9.13 (VEE), U9.20 (VEE), U9.21 (VEE), U9.28 (VEE), U9.29 (VEE), U26.11 (V-), U27.11 (V-), U28.11 (V-), U29.11 (V-), U35.8 (OUT)
/Power_Supply/EN: R123.2, R124.1, U23.10 (EN)
/Power_Supply/FB: R1.2, R141.2, U35.9 (FB)
/Power_Supply/REFIN: C93.1, R142.1, R143.1, U33.1 (REFIN)
/Power_Supply/VREF: C90.2, R1.1, U35.10 (VREF)
/Power_Supply/VSENSE: R121.2, R122.1, U23.7 (VSENSE)
DAC_CS0_N: U24.2 (SYNC#), U37.G24 (IO_L14P_T2_SRCC_14)
DAC_CS1_N: U25.2 (SYNC#), U37.F24 (IO_L14N_T2_SRCC_14)
DAC_OUT_0: U24.4 (VOUTA), U26.3 (+)
DAC_OUT_1: U24.13 (VOUTB), U26.5 (+)
DAC_OUT_2: U24.5 (VOUTC), U26.10 (+)
DAC_OUT_3: U24.12 (VOUTD), U26.12 (+)
DAC_OUT_4: U24.6 (VOUTE), U27.3 (+)
DAC_OUT_5: U24.11 (VOUTF), U27.5 (+)
DAC_OUT_6: U24.7 (VOUTG), U27.10 (+)
DAC_OUT_7: U24.10 (VOUTH), U27.12 (+)
DAC_OUT_8: U25.4 (VOUTA), U28.3 (+)
DAC_OUT_9: U25.13 (VOUTB), U28.5 (+)
DAC_OUT_10: U25.5 (VOUTC), U28.10 (+)
DAC_OUT_11: U25.12 (VOUTD), U28.12 (+)
DAC_OUT_12: U25.6 (VOUTE), U29.3 (+)
DAC_OUT_13: U25.11 (VOUTF), U29.5 (+)
DAC_OUT_14: U25.7 (VOUTG), U29.10 (+)
DAC_OUT_15: U25.10 (VOUTH), U29.12 (+)
DAC_SPI_MOSI: U24.15 (DIN), U25.15 (DIN), U37.F23 (IO_L13N_T2_MRCC_14)
DAC_SPI_SCLK: U24.16 (SCLK), U25.16 (SCLK), U37.G22 (IO_L13P_T2_MRCC_14)
DDR_A0: U1.N3 (A0), U37.AF2 (IO_L24N_T3_34)
DDR_A1: U1.P7 (A1), U37.AF3 (IO_L24P_T3_34)
DDR_A2: U1.P3 (A2), U37.AE5 (IO_L23N_T3_34)
DDR_A3: U1.N2 (A3), U37.AE6 (IO_L23P_T3_34)
DDR_A4: U1.P8 (A4), U37.AE2 (IO_L22N_T3_34)
DDR_A5: U1.P2 (A5), U37.AE3 (IO_L22P_T3_34)
DDR_A6: U1.R8 (A6), U37.AF4 (IO_L21N_T3_DQS_34)
DDR_A7: U1.R2 (A7), U37.AF5 (IO_L21P_T3_DQS_34)
DDR_A8: U1.T8 (A8), U37.AE1 (IO_L20N_T3_34)
DDR_A9: U1.R3 (A9), U37.AD1 (IO_L20P_T3_34)
DDR_A10: U1.L7 (A10/AP), U37.AD3 (IO_L19N_T3_VREF_34)
DDR_A11: U1.R7 (A11), U37.AD5 (IO_L18N_T2_34)
DDR_A12: U1.N7 (A12/~BC), U37.AD6 (IO_L18P_T2_34)
DDR_A13: U1.T3 (A13), U37.Y5 (IO_L17N_T2_34)
DDR_A14: U1.T7 (A14), U37.Y6 (IO_L17P_T2_34)
DDR_BA0: U1.M2 (BA0), U37.AC6 (IO_L16N_T2_34)
DDR_BA1: U1.N8 (BA1), U37.AB6 (IO_L16P_T2_34)
DDR_BA2: U1.M3 (BA2), U37.AB5 (IO_L15N_T2_DQS_34)
DDR_CAS_N: U1.K3 (~CAS), U37.AC3 (IO_L14N_T2_SRCC_34)
DDR_CKE: U1.K9 (CKE), U37.AA4 (IO_L13P_T2_MRCC_34)
DDR_CK_N: R118.2, U1.K7 (~CK), U37.AA2 (IO_L12N_T1_MRCC_34)
DDR_CK_P: R118.1, U1.J7 (CK), U37.AA3 (IO_L12P_T1_MRCC_34)
DDR_CS_N: U1.L2 (~CS), U37.AB4 (IO_L13N_T2_MRCC_34)
DDR_DQ0: U1.E3 (DQ0), U37.U6 (IO_L1P_T0_34)
DDR_DQ1: U1.F7 (DQ1), U37.U5 (IO_L1N_T0_34)
DDR_DQ2: U1.F2 (DQ2), U37.U2 (IO_L2P_T0_34)
DDR_DQ3: U1.F8 (DQ3), U37.U1 (IO_L2N_T0_34)
DDR_DQ4: U1.H3 (DQ4), U37.V3 (IO_L4P_T0_34)
DDR_DQ5: U1.H8 (DQ5), U37.W3 (IO_L4N_T0_34)
DDR_DQ6: U1.G2 (DQ6), U37.U7 (IO_L5P_T0_34)
DDR_DQ7: U1.H7 (DQ7), U37.V6 (IO_L5N_T0_34)
DDR_DQ8: U1.D7 (DQ8), U37.Y3 (IO_L7P_T1_34)
DDR_DQ9: U1.C3 (DQ9), U37.Y2 (IO_L7N_T1_34)
DDR_DQ10: U1.C8 (DQ10), U37.V2 (IO_L8P_T1_34)
DDR_DQ11: U1.C2 (DQ11), U37.V1 (IO_L8N_T1_34)
DDR_DQ12: U1.A7 (DQ12), U37.W1 (IO_L10P_T1_34)
DDR_DQ13: U1.A2 (DQ13), U37.Y1 (IO_L10N_T1_34)
DDR_DQ14: U1.B8 (DQ14), U37.AB2 (IO_L11P_T1_SRCC_34)
DDR_DQ15: U1.A3 (DQ15), U37.AC2 (IO_L11N_T1_SRCC_34)
DDR_LDM: U1.E7 (LDM), U37.V4 (IO_L6P_T0_34)
DDR_LDQS_N: U1.G3 (~LDQS), U37.W5 (IO_L3N_T0_DQS_34)
DDR_LDQS_P: U1.F3 (LDQS), U37.W6 (IO_L3P_T0_DQS_34)
DDR_ODT: U1.K1 (ODT), U37.T7 (IO_25_VRP_34)
DDR_RAS_N: U1.J3 (~RAS), U37.AA5 (IO_L15P_T2_DQS_34)
DDR_RESET_N: R8.2, U1.T2 (~RESET), U37.AD4 (IO_L19P_T3_34)
DDR_UDM: U1.D3 (UDM), U37.W4 (IO_L6N_T0_VREF_34)
DDR_UDQS_N: U1.B7 (~UDQS), U37.AC1 (IO_L9N_T1_DQS_34)
DDR_UDQS_P: U1.C7 (UDQS), U37.AB1 (IO_L9P_T1_DQS_34)
DDR_WE_N: U1.L3 (~WE), U37.AC4 (IO_L14P_T2_SRCC_34)
FPGA_CCLK: U4.6 (CLK), U37.C8 (CCLK_0)
FPGA_D00_MOSI: U4.5 (DI/IO_{0}), U37.B24 (IO_L1P_T0_D00_MOSI_14), U37.J23 (IO_L24N_T3_A00_D16_14)
FPGA_D01_DIN: U4.2 (DO/IO_{1}), U37.A25 (IO_L1N_T0_D01_DIN_14), U37.J24 (IO_L22P_T3_A05_D21_14)
FPGA_D02: R117.2, U4.3 (~WP/IO_{2}), U37.B22 (IO_L2P_T0_D02_14), U37.H23 (IO_L20P_T3_A08_D24_14)
FPGA_D03: R119.2, U4.7 (~HOLD/~RESET/IO_{3}), U37.A22 (IO_L2N_T0_D03_14), U37.H24 (IO_L20N_T3_A07_D23_14)
FPGA_FCS_B: U4.1 (~CS), U37.C23 (IO_L6P_T0_FCS_B_14), U37.L23 (IO_25_14)
FT_BE0: U37.G17 (IO_L11P_T1_SRCC_AD12P_15), U42.4 (BE_0)
FT_BE1: U37.F17 (IO_L12P_T1_MRCC_AD5P_15), U42.5 (BE_1)
FT_BE2: U37.E17 (IO_L12N_T1_MRCC_AD5N_15), U42.6 (BE_2)
FT_BE3: U37.K15 (IO_0_15), U42.7 (BE_3)
FT_CLK: R110.2, U37.E18 (IO_L13P_T2_MRCC_15)
FT_DATA0: U37.C16 (IO_L1P_T0_AD0P_15), U42.40 (DATA_0)
FT_DATA1: U37.B16 (IO_L1N_T0_AD0N_15), U42.41 (DATA_1)
FT_DATA2: U37.A18 (IO_L2P_T0_AD8P_15), U42.42 (DATA_2)
FT_DATA3: U37.A19 (IO_L2N_T0_AD8N_15), U42.43 (DATA_3)
FT_DATA4: U37.B17 (IO_L3P_T0_DQS_AD1P_15), U42.44 (DATA_4)
FT_DATA5: U37.A17 (IO_L3N_T0_DQS_AD1N_15), U42.45 (DATA_5)
FT_DATA6: U37.C17 (IO_L5P_T0_AD2P_15), U42.46 (DATA_6)
FT_DATA7: U37.C18 (IO_L5N_T0_AD2N_15), U42.47 (DATA_7)
FT_DATA8: U37.D15 (IO_L6P_T0_15), U42.50 (DATA_8)
FT_DATA9: U37.D16 (IO_L6N_T0_VREF_15), U42.51 (DATA_9)
FT_DATA10: U37.H16 (IO_L7P_T1_AD10P_15), U42.52 (DATA_10)
FT_DATA11: U37.G16 (IO_L7N_T1_AD10N_15), U42.53 (DATA_11)
FT_DATA12: U37.G15 (IO_L8P_T1_AD3P_15), U42.54 (DATA_12)
FT_DATA13: U37.F15 (IO_L8N_T1_AD3N_15), U42.55 (DATA_13)
FT_DATA14: U37.J15 (IO_L9P_T1_DQS_AD11P_15), U42.56 (DATA_14)
FT_DATA15: U37.J16 (IO_L9N_T1_DQS_AD11N_15), U42.57 (DATA_15)
FT_DATA16: U37.E15 (IO_L10P_T1_AD4P_15), U42.60 (DATA_16)
FT_DATA17: U37.E16 (IO_L10N_T1_AD4N_15), U42.61 (DATA_17)
FT_DATA18: U37.M16 (IO_25_15), U42.62 (DATA_18)
FT_DATA19: U37.K18 (IO_L24N_T3_RS0_15), U42.63 (DATA_19)
FT_DATA20: U37.L17 (IO_L24P_T3_RS1_15), U42.64 (DATA_20)
FT_DATA21: U37.L18 (IO_L23N_T3_FWE_B_15), U42.65 (DATA_21)
FT_DATA22: U37.M17 (IO_L23P_T3_FOE_B_15), U42.66 (DATA_22)
FT_DATA23: U37.K17 (IO_L22N_T3_A16_15), U42.67 (DATA_23)
FT_DATA24: U37.K16 (IO_L22P_T3_A17_15), U42.69 (DATA_24)
FT_DATA25: U37.L20 (IO_L21N_T3_DQS_A18_15), U42.70 (DATA_25)
FT_DATA26: U37.L19 (IO_L21P_T3_DQS_15), U42.71 (DATA_26)
FT_DATA27: U37.J19 (IO_L20N_T3_A19_15), U42.72 (DATA_27)
FT_DATA28: U37.J18 (IO_L20P_T3_A20_15), U42.73 (DATA_28)
FT_DATA29: U37.J20 (IO_L19N_T3_A21_VREF_15), U42.74 (DATA_29)
FT_DATA30: U37.K20 (IO_L19P_T3_A22_15), U42.75 (DATA_30)
FT_DATA31: U37.G20 (IO_L18N_T2_A23_15), U42.76 (DATA_31)
FT_OE_N: U37.F18 (IO_L11N_T1_SRCC_AD12N_15), U42.13 (~OE)
FT_RD_N: U37.D18 (IO_L13N_T2_MRCC_15), U42.12 (~RD)
FT_RESET_N: R111.1, U37.H18 (IO_L14N_T2_SRCC_15), U42.15 (~RESET)
FT_RXF_N: U37.B19 (IO_L4N_T0_AD9N_15), U42.9 (~RXF)
FT_TXE_N: U37.C19 (IO_L4P_T0_AD9P_15), U42.8 (~TXE)
FT_WR_N: U37.H17 (IO_L14P_T2_SRCC_15), U42.11 (~WR)
GND: C1.1, C10.1, C11.1, C12.1, C13.1, C14.1, C15.1, C16.2, C18.2, C19.2, C20.2, C21.2, C22.2, C23.2, C24.2, C25.2, C26.2, C27.2, C28.2, C29.2, C30.2, C31.2, C32.2, C33.2, C34.2, C35.2, C36.2, C37.1, C38.1, C39.1, C42.1, C43.2, C44.2, C45.2, C46.2, C47.2, C48.1, C49.2, C50.1, C51.1, C52.2, C53.2, C54.2, C55.1, C56.1, C57.1, C58.1, C59.1, C60.1, C61.1, C62.1, C63.1, C64.1, C66.2, C67.2, C68.1, C69.2, C70.1, C71.1, C73.1, C75.1, C76.1, C77.1, C78.1, C79.2, C80.2, C82.1, C83.2, C84.2, C85.2, C86.2, C87.1, C89.1, C90.1, C91.2, C92.1, C93.2, C94.1, C95.1, C96.1, C97.1, C98.1, C99.1, C100.1, C101.1, C102.1, C103.1, C104.1, C105.1, C106.1, C107.1, C108.1, C109.1, C110.1, C111.1, C112.1, C113.1, C114.1, C115.1, C116.1, C117.1, C118.1, C119.1, C120.1, C121.1, C122.1, C123.1, D1.1 (K), D3.1 (A1), H1.1 (1_1), H2.1 (1_1), H3.1 (1_1), H4.1 (1_1), J1.1 (VeeT), J1.9 (VeeR), J1.10 (VeeR), J1.11 (VeeR), J1.14 (VeeR), J1.17 (VeeT), J1.20 (VeeT), J1.CAGE, J2.1 (VeeT), J2.9 (VeeR), J2.10 (VeeR), J2.11 (VeeR), J2.14 (VeeR), J2.17 (VeeT), J2.20 (VeeT), J2.CAGE, J3.1 (VeeT), J3.9 (VeeR), J3.10 (VeeR), J3.11 (VeeR), J3.14 (VeeR), J3.17 (VeeT), J3.20 (VeeT), J3.CAGE, J4.A1 (GND), J4.A12 (GND), J4.B1 (GND), J4.B12 (GND), J4.SH (SHIELD), J5.1, J5.3, J5.5, J5.7, J5.9, J5.11, J5.13, J6.2, J6.4, J6.6, J6.8, J6.10, J6.12, J6.14, J6.16, J6.17, J6.18, J6.19, J6.20, J7.2, J7.4, J7.6, J7.8, J7.10, J7.12, J7.14, J7.16, J7.17, J7.18, J7.19, J7.20, J8.2 (Ext), J9.2, L6.2, R8.1, R9.1, R11.2, R12.1, R14.2, R15.1, R17.2, R18.1, R20.2, R21.1, R23.2, R24.1, R26.2, R27.1, R29.2, R30.1, R32.2, R33.1, R35.2, R36.1, R39.2, R40.1, R41.2, R42.1, R45.2, R46.1, R47.2, R48.1, R51.2, R52.1, R53.2, R54.1, R56.2, R57.1, R58.2, R59.2, R61.1, R63.1, R65.1, R67.1, R69.1, R71.1, R73.1, R75.1, R77.1, R79.1, R81.1, R83.1, R85.1, R87.1, R89.1, R91.1, R92.2, R93.2, R113.2, R122.2, R124.2, R125.2, R127.1, R128.1, R130.1, R133.1, R139.1, R143.2, R145.1, RJ1.S1, RJ1.S2, SW1.2, U1.A9 (V_{SS}), U1.B1 (V_{SSQ}), U1.B3 (V_{SS}), U1.B9 (V_{SSQ}), U1.D1 (V_{SSQ}), U1.D8 (V_{SSQ}), U1.E1 (V_{SS}), U1.E2 (V_{SSQ}), U1.E8 (V_{SSQ}), U1.F9 (V_{SSQ}), U1.G1 (V_{SSQ}), U1.G8 (V_{SS}), U1.G9 (V_{SSQ}), U1.J2 (V_{SS}), U1.J8 (V_{SS}), U1.M1 (V_{SS}), U1.M9 (V_{SS}), U1.P1 (V_{SS}), U1.P9 (V_{SS}), U1.T1 (V_{SS}), U1.T9 (V_{SS}), U3.29 (VSS), U3.49 (PAD_GND), U4.4 (GND), U5.1 (GND), U22.4 (GND), U23.2 (GND), U23.3 (GND), U23.15 (EP), U24.1 (LDAC#), U24.14 (GND), U25.1 (LDAC#), U25.14 (GND), U30.1 (GND), U31.2 (GND), U32.2 (GND), U33.4 (GND), U33.8 (GND), U33.11 (GND), U34.1 (GND), U35.2 (GND), U35.7 (PS_GND), U35.11 (GND), U36.1 (GND), U37.A1 (GND), U37.A2 (GND), U37.A5 (GND), U37.A6 (GND), U37.A7 (GND), U37.A16 (GND), U37.A26 (GND), U37.AA6 (GND), U37.AA16 (GND), U37.AA26 (GND), U37.AB3 (GND), U37.AB13 (GND), U37.AB23 (GND), U37.AC10 (GND), U37.AC20 (GND), U37.AD7 (GND), U37.AD17 (GND), U37.AE4 (GND), U37.AE14 (GND), U37.AE24 (GND), U37.AF1 (GND), U37.AF11 (GND), U37.AF21 (GND), U37.B4 (GND), U37.B7 (GND), U37.B13 (GND), U37.B23 (GND), U37.C1 (GND), U37.C5 (GND), U37.C7 (GND), U37.C10 (GND), U37.C20 (GND), U37.D4 (GND), U37.D7 (GND), U37.D17 (GND), U37.E1 (GND), U37.E2 (GND), U37.E5 (GND), U37.E7 (GND), U37.E14 (GND), U37.E24 (GND), U37.F3 (GND), U37.F4 (GND), U37.F7 (GND), U37.F11 (GND), U37.F21 (GND), U37.G1 (GND), U37.G5 (GND), U37.G8 (GND), U37.G18 (GND), U37.H4 (GND), U37.H7 (GND), U37.H15 (GND), U37.H25 (GND), U37.J1 (GND), U37.J2 (GND), U37.J5 (GND), U37.J12 (GND), U37.J22 (GND), U37.K3 (GND), U37.K4 (GND), U37.K7 (GND), U37.K9 (GND), U37.K11 (GND), U37.K13 (GND), U37.K19 (GND), U37.L1 (GND), U37.L5 (GND), U37.L10 (GND), U37.L12 (GND), U37.L14 (GND), U37.L16 (GND), U37.L26 (GND), U37.M4 (GND), U37.M7 (GND), U37.M9 (GND), U37.M13 (GND), U37.M15 (GND), U37.M23 (GND), U37.N1 (GND), U37.N2 (GND), U37.N5 (GND), U37.N7 (GND), U37.N10 (GND), U37.N14 (GND), U37.N20 (GND), U37.P3 (GND), U37.P4 (GND), U37.P5 (M2_0), U37.P9 (GND), U37.P13 (GND), U37.P15 (GND), U37.P17 (GND), U37.R1 (GND), U37.R2 (GND), U37.R5 (GND), U37.R8 (GND), U37.R10 (GND), U37.R14 (GND), U37.R24 (GND), U37.T1 (GND), U37.T2 (M1_0), U37.T3 (GND), U37.T4 (GND), U37.T9 (GND), U37.T11 (GND), U37.T13 (GND), U37.T15 (GND), U37.T21 (GND), U37.U8 (GND), U37.U10 (GND), U37.U12 (GND), U37.U14 (GND), U37.U18 (GND), U37.V5 (GND), U37.V15 (GND), U37.V25 (GND), U37.W2 (GND), U37.W12 (GND), U37.W22 (GND), U37.Y9 (GND), U37.Y19 (GND), U42.1 (GND), U42.26 (GND), U42.29 (GND), U42.36 (GND), U42.77 (GND), Y2.3 (GND)
INGRESSO_SONDA_0: J6.1, R10.1
INGRESSO_SONDA_1: J6.3, R13.1
INGRESSO_SONDA_2: J6.5, R16.1
INGRESSO_SONDA_3: J6.7, R38.1
INGRESSO_SONDA_4: J6.9, R44.1
INGRESSO_SONDA_5: J6.11, R49.1
INGRESSO_SONDA_6: J6.13, R19.1
INGRESSO_SONDA_7: J6.15, R22.1
INGRESSO_SONDA_8: J7.1, R25.1
INGRESSO_SONDA_9: J7.3, R37.1
INGRESSO_SONDA_10: J7.5, R43.1
INGRESSO_SONDA_11: J7.7, R50.1
INGRESSO_SONDA_12: J7.9, R28.1
INGRESSO_SONDA_13: J7.11, R31.1
INGRESSO_SONDA_14: J7.13, R34.1
INGRESSO_SONDA_15: J7.15, R55.1
JTAG_TCK: J5.6, U37.L8 (TCK_0)
JTAG_TDI: J5.10, U37.R6 (TDI_0)
JTAG_TDO: J5.8, U37.R7 (TDO_0)
JTAG_TMS: J5.4, U37.N8 (TMS_0)
MDC: U3.36 (MDC), U37.F14 (IO_L15P_T2_DQS_16)
MDIO: R114.2, U3.37 (MDIO), U37.F13 (IO_L15N_T2_DQS_16)
MGT_REFCLK_N: C17.2, U37.H5 (MGTREFCLK0N_115)
MGT_REFCLK_P: C124.2, U37.H6 (MGTREFCLK0P_115)
MGT_RX0_N: C7.1, U37.R3 (MGTXRXN0_115)
MGT_RX0_P: C6.2, U37.R4 (MGTXRXP0_115)
MGT_RX1_N: C5.2, U37.N3 (MGTXRXN1_115)
MGT_RX1_P: C4.2, U37.N4 (MGTXRXP1_115)
MGT_RX2_N: C3.2, U37.L3 (MGTXRXN2_115)
MGT_RX2_P: C2.2, U37.L4 (MGTXRXP2_115)
MGT_TX2_N: C9.2, U37.K1 (MGTXTXN2_115)
MGT_TX2_P: C8.2, U37.K2 (MGTXTXP2_115)
unnamed: C65.2, L2.1, U23.11 (PH), U23.12 (PH)
unnamed: C66.1, R120.2
unnamed: C87.2, R132.1
unnamed: D1.2 (A), R148.2, U37.J7 (DONE_0)
unnamed: F2.1, J9.1
unnamed: C6.1, J1.13 (RD+)
unnamed: C7.2, J1.12 (RD-)
unnamed: J1.3 (TX_DISABLE), R3.2
unnamed: C10.2, C11.2, FB4.1, J1.15 (VccR), J1.16 (VccT)
unnamed: C4.1, J2.13 (RD+)
unnamed: C5.1, J2.12 (RD-)
unnamed: J2.3 (TX_DISABLE), R2.2
unnamed: C12.2, C13.2, FB5.1, J2.15 (VccR), J2.16 (VccT)
unnamed: C2.1, J3.13 (RD+)
unnamed: C3.1, J3.12 (RD-)
unnamed: C8.1, J3.18 (TD+)
unnamed: C9.1, J3.19 (TD-)
unnamed: C14.2, C15.2, FB6.1, J3.15 (VccR), J3.16 (VccT)
unnamed: J4.A5 (CC1), R92.1
unnamed: J4.B5 (CC2), R93.1
unnamed: Q2.1 (G), R133.2
unnamed: F2.2, Q2.2 (S)
unnamed: R9.2, U1.L8 (ZQ)
unnamed: R59.1, U3.48 (ISET)
unnamed: C50.2, U3.46 (XI), Y4.1 (1_1)
unnamed: C49.1, U3.45 (XO)
unnamed: C72.2, L3.1, U5.2 (SW)
unnamed: C72.1, U5.6 (VBST)
unnamed: R126.1, R127.2, U5.4 (VFB)
unnamed: D18.3 (K), R10.2, U6.30 (+)
unnamed: D19.3 (K), R13.2, U6.11 (+)
unnamed: D20.3 (K), R16.2, U6.14 (+)
unnamed: D21.3 (K), R38.2, U6.27 (+)
unnamed: D22.3 (K), R44.2, U7.30 (+)
unnamed: D23.3 (K), R49.2, U7.11 (+)
unnamed: D24.3 (K), R19.2, U7.14 (+)
unnamed: D25.3 (K), R22.2, U7.27 (+)
unnamed: D26.3 (K), R25.2, U8.30 (+)
unnamed: D27.3 (K), R37.2, U8.11 (+)
unnamed: D28.3 (K), R43.2, U8.14 (+)
unnamed: D29.3 (K), R50.2, U8.27 (+)
unnamed: D30.3 (K), R28.2, U9.30 (+)
unnamed: D31.3 (K), R31.2, U9.11 (+)
unnamed: D32.3 (K), R34.2, U9.14 (+)
unnamed: D33.3 (K), R55.2, U9.27 (+)
unnamed: C35.1, U22.5 (Trim/NR)
unnamed: C65.1, U23.13 (BOOT)
unnamed: C67.1, R120.1, U23.8 (COMP)
unnamed: R125.1, U23.1 (RT/CLK)
unnamed: C69.1, U23.9 (SS/TR)
unnamed: R60.2, R61.2, R94.2, U26.2 (-)
unnamed: R62.2, R63.2, R101.2, U26.6 (-)
unnamed: R64.2, R65.2, R102.2, U26.9 (-)
unnamed: R66.2, R67.2, R103.2, U26.13 (-)
unnamed: R68.2, R69.2, R95.2, U27.2 (-)
unnamed: R70.2, R71.2, R100.2, U27.6 (-)
unnamed: R72.2, R73.2, R109.2, U27.9 (-)
unnamed: R74.2, R75.2, R104.2, U27.13 (-)
unnamed: R76.2, R77.2, R96.2, U28.2 (-)
unnamed: R78.2, R79.2, R99.2, U28.6 (-)
unnamed: R80.2, R81.2, R108.2, U28.9 (-)
unnamed: R82.2, R83.2, R105.2, U28.13 (-)
unnamed: R84.2, R85.2, R97.2, U29.2 (-)
unnamed: R86.2, R87.2, R98.2, U29.6 (-)
unnamed: R88.2, R89.2, R107.2, U29.9 (-)
unnamed: R90.2, R91.2, R106.2, U29.13 (-)
unnamed: C74.2, L4.1, U30.2 (SW)
unnamed: C74.1, U30.6 (VBST)
unnamed: R128.2, R129.1, U30.4 (VFB)
unnamed: C81.2, L5.1, U34.2 (SW)
unnamed: C81.1, U34.6 (VBST)
unnamed: R130.2, R131.1, U34.4 (VFB)
unnamed: R132.2, U35.1 (COMP)
unnamed: L6.1, U35.6 (SW)
unnamed: C88.2, L7.1, U36.2 (SW)
unnamed: C88.1, U36.6 (VBST)
unnamed: R139.2, R140.1, U36.4 (VFB)
unnamed: R150.2, U37.G7 (INIT_B_0)
unnamed: R149.2, U37.T5 (M0_0)
unnamed: R146.2, SW1.1, U37.P6 (PROGRAM_B_0)
unnamed: R145.2, U37.M6 (MGTRREF_115)
unnamed: R110.1, U42.58 (CLK)
unnamed: C47.1, C48.2, U42.3 (VD10), U42.30 (VD10), U42.33 (VD10), U42.39 (DV10), U42.48 (VD10)
unnamed: R58.1, U42.27 (RREF)
unnamed: C40.2, U42.31 (TODN)
unnamed: C41.2, U42.32 (TODP)
unnamed: C39.2, J4.A4 (VBUS), J4.A9 (VBUS), J4.B4 (VBUS), J4.B9 (VBUS), U42.37 (VBUS)
unnamed: C43.1, U42.21 (XI), Y3.2
unnamed: C42.2, U42.22 (XO), Y3.1
unnamed: R112.1, U42.10 (~SIWU)
unnamed: R113.1, U42.16 (~WAKEUP)
unnamed: C124.1, Y2.4 (OUT+)
unnamed: C17.1, Y2.5 (OUT-)
PHY_INT_N: R116.2, U3.38 (INT_N/PME_N2), U37.E11 (IO_L14P_T2_SRCC_16)
PHY_RESET_N: R115.2, U3.42 (RESET_N), U37.D11 (IO_L14N_T2_SRCC_16)
RGMII_RXC: U3.35 (RX_CLK/PHYAD2), U37.E10 (IO_L12P_T1_MRCC_16)
RGMII_RXD0: U3.32 (RXD0/MODE0), U37.G11 (IO_L11P_T1_SRCC_16)
RGMII_RXD1: U3.31 (RXD1/MODE1), U37.F10 (IO_L11N_T1_SRCC_16)
RGMII_RXD2: U3.28 (RXD2/MODE2), U37.C9 (IO_L10P_T1_16)
RGMII_RXD3: U3.27 (RXD3/MODE3), U37.B9 (IO_L10N_T1_16)
RGMII_RX_CTL: U3.33 (RX_DV/CLK125_EN), U37.D10 (IO_L12N_T1_MRCC_16)
RGMII_TXC: U3.24 (GTX_CLK), U37.A9 (IO_L9P_T1_DQS_16)
RGMII_TXD0: U3.19 (TXD0), U37.D9 (IO_L8P_T1_16)
RGMII_TXD1: U3.20 (TXD1), U37.D8 (IO_L8N_T1_16)
RGMII_TXD2: U3.21 (TXD2), U37.C11 (IO_L13N_T2_MRCC_16)
RGMII_TXD3: U3.22 (TXD3), U37.C12 (IO_L13P_T2_MRCC_16)
RGMII_TX_CTL: U3.25 (TX_EN), U37.A8 (IO_L9N_T1_DQS_16)
SFP1_LOS: J1.8 (RX_LOS), R4.2, U37.E25 (IO_L15P_T2_DQS_RDWR_B_14), U37.G25 (IO_L16P_T2_CSI_B_14)
SFP2_LOS: J2.8 (RX_LOS), R5.2, U37.B25 (IO_L3P_T0_DQS_PUDC_B_14), U37.G26 (IO_L16N_T2_A15_D31_14)
SFP3_LOS: J3.8 (RX_LOS), R6.2, U37.J26 (IO_L18P_T2_A12_D28_14)
SFP3_TXDIS: J3.3 (TX_DISABLE), R7.2, U37.E26 (IO_L17N_T2_A13_D29_14)
SOGLIA_VTH_0: C19.1, R94.1, U6.31 (-), U26.1
SOGLIA_VTH_1: C20.1, R101.1, U6.10 (-), U26.7
SOGLIA_VTH_2: C21.1, R102.1, U6.15 (-), U26.8
SOGLIA_VTH_3: C29.1, R103.1, U6.26 (-), U26.14
SOGLIA_VTH_4: C31.1, R95.1, U7.31 (-), U27.1
SOGLIA_VTH_5: C32.1, R100.1, U7.10 (-), U27.7
SOGLIA_VTH_6: C22.1, R109.1, U7.15 (-), U27.8
SOGLIA_VTH_7: C23.1, R104.1, U7.26 (-), U27.14
SOGLIA_VTH_8: C24.1, R96.1, U8.31 (-), U28.1
SOGLIA_VTH_9: C28.1, R99.1, U8.10 (-), U28.7
SOGLIA_VTH_10: C30.1, R108.1, U8.15 (-), U28.8
SOGLIA_VTH_11: C33.1, R105.1, U8.26 (-), U28.14
SOGLIA_VTH_12: C25.1, R97.1, U9.31 (-), U29.1
SOGLIA_VTH_13: C26.1, R98.1, U9.10 (-), U29.7
SOGLIA_VTH_14: C27.1, R107.1, U9.15 (-), U29.8
SOGLIA_VTH_15: C34.1, R106.1, U9.26 (-), U29.14
SYSCLK_100M: R144.2, U37.AC9 (IO_L12P_T1_MRCC_33)
TRIG_IN: D2.3 (K), J8.1 (In), U37.AD9 (IO_L12N_T1_MRCC_33)
TXRXM_A: RJ1.2, U3.3 (TXRXM_A)
TXRXM_B: RJ1.4, U3.6 (TXRXM_B)
TXRXM_C: RJ1.6, U3.8 (TXRXM_C)
TXRXM_D: RJ1.8, U3.11 (TXRXM_D)
TXRXP_A: RJ1.1, U3.2 (TXRXP_A)
TXRXP_B: RJ1.3, U3.5 (TXRXP_B)
TXRXP_C: RJ1.5, U3.7 (TXRXP_C)
TXRXP_D: RJ1.7, U3.10 (TXRXP_D)
USB_DM: J4.A7 (D-), J4.B7 (D-), U42.25 (DM)
USB_DP: J4.A6 (D+), J4.B6 (D+), U42.23 (DP)
USCITA_FPGA_0_N: R12.2, U6.2 (~Q), U37.W11 (IO_L1N_T0_33)
USCITA_FPGA_0_P: R11.1, U6.3 (Q), U37.V11 (IO_L1P_T0_33)
USCITA_FPGA_1_N: R15.2, U6.7 (~Q), U37.V7 (IO_L2N_T0_33)
USCITA_FPGA_1_P: R14.1, U6.6 (Q), U37.V8 (IO_L2P_T0_33)
USCITA_FPGA_2_N: R18.2, U6.18 (~Q), U37.W9 (IO_L3N_T0_DQS_33)
USCITA_FPGA_2_P: R17.1, U6.19 (Q), U37.W10 (IO_L3P_T0_DQS_33)
USCITA_FPGA_3_N: R42.2, U6.23 (~Q), U37.Y7 (IO_L4N_T0_33)
USCITA_FPGA_3_P: R41.1, U6.22 (Q), U37.Y8 (IO_L4P_T0_33)
USCITA_FPGA_4_N: R48.2, U7.2 (~Q), U37.Y10 (IO_L5N_T0_33)
USCITA_FPGA_4_P: R47.1, U7.3 (Q), U37.Y11 (IO_L5P_T0_33)
USCITA_FPGA_5_N: R52.2, U7.7 (~Q), U37.W8 (IO_L6N_T0_VREF_33)
USCITA_FPGA_5_P: R51.1, U7.6 (Q), U37.V9 (IO_L6P_T0_33)
USCITA_FPGA_6_N: R21.2, U7.18 (~Q), U37.AF7 (IO_L7N_T1_33)
USCITA_FPGA_6_P: R20.1, U7.19 (Q), U37.AE7 (IO_L7P_T1_33)
USCITA_FPGA_7_N: R24.2, U7.23 (~Q), U37.AA7 (IO_L8N_T1_33)
USCITA_FPGA_7_P: R23.1, U7.22 (Q), U37.AA8 (IO_L8P_T1_33)
USCITA_FPGA_8_N: R27.2, U8.2 (~Q), U37.AD8 (IO_L9N_T1_DQS_33)
USCITA_FPGA_8_P: R26.1, U8.3 (Q), U37.AC8 (IO_L9P_T1_DQS_33)
USCITA_FPGA_9_N: R40.2, U8.7 (~Q), U37.AC7 (IO_L10N_T1_33)
USCITA_FPGA_9_P: R39.1, U8.6 (Q), U37.AB7 (IO_L10P_T1_33)
USCITA_FPGA_10_N: R46.2, U8.18 (~Q), U37.AB9 (IO_L11N_T1_SRCC_33)
USCITA_FPGA_10_P: R45.1, U8.19 (Q), U37.AA9 (IO_L11P_T1_SRCC_33)
USCITA_FPGA_11_N: R54.2, U8.23 (~Q), U37.AC11 (IO_L13N_T2_MRCC_33)
USCITA_FPGA_11_P: R53.1, U8.22 (Q), U37.AB11 (IO_L13P_T2_MRCC_33)
USCITA_FPGA_12_N: R30.2, U9.2 (~Q), U37.AB10 (IO_L14N_T2_SRCC_33)
USCITA_FPGA_12_P: R29.1, U9.3 (Q), U37.AA10 (IO_L14P_T2_SRCC_33)
USCITA_FPGA_13_N: R33.2, U9.7 (~Q), U37.AC12 (IO_L15N_T2_DQS_33)
USCITA_FPGA_13_P: R32.1, U9.6 (Q), U37.AB12 (IO_L15P_T2_DQS_33)
USCITA_FPGA_14_N: R36.2, U9.18 (~Q), U37.AA12 (IO_L16N_T2_33)
USCITA_FPGA_14_P: R35.1, U9.19 (Q), U37.AA13 (IO_L16P_T2_33)
USCITA_FPGA_15_N: R57.2, U9.23 (~Q), U37.AD13 (IO_L17N_T2_33)
USCITA_FPGA_15_P: R56.1, U9.22 (Q), U37.AC13 (IO_L17P_T2_33)
VREF_2V5: C36.1, R60.1, R62.1, R64.1, R66.1, R68.1, R70.1, R72.1, R74.1, R76.1, R78.1, R80.1, R82.1, R84.1, R86.1, R88.1, R90.1, U22.6 (Vout), U24.8 (VREFIN/VREFOUT), U25.8 (VREFIN/VREFOUT)
