HexFud/OptiLogic-16-Pro/(commit log)

2026-10-25 Fixed missing connections
    [OptiLogic-16-Pro.kicad_pcb]
2026-10-25 Revise README with comprehensive project details
    Updated project description and added detailed sections on schematic, PCB design, external connections, mechanical design, firmware flashing instructions, thermal recommendations, and safety advice.
2026-10-25 Add SPI controller module for DAC8568
